eawag-squid/SQUID/img/plugged.JPG

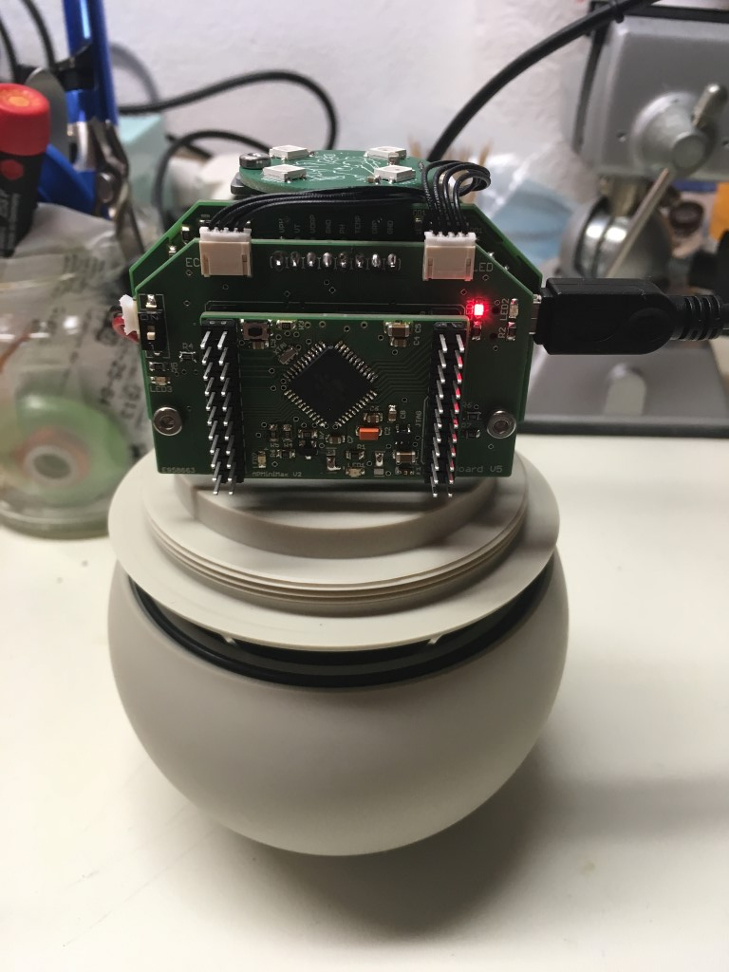
img/plugged.JPG
