eawag-squid/SQUID/img/Window_6.JPG

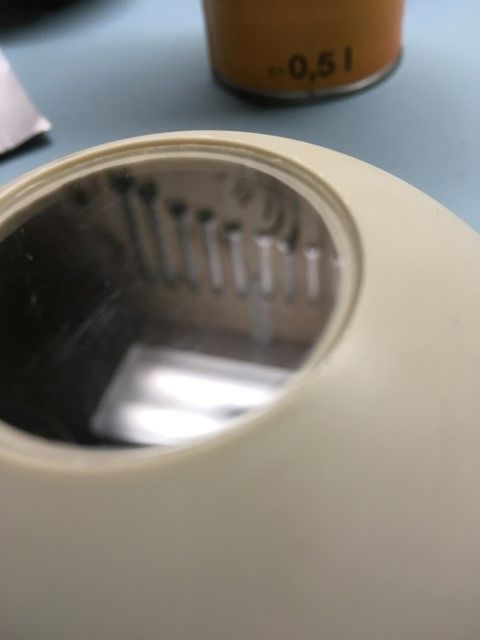
img/Window_6.JPG
