eawag-squid/SQUID/README.md

# SQUID
Repository holding Eawag's SQUID user documentation and latest firmware versions.
Check back frequently!

Check the [wiki](https://github.com/eawag-squid/SQUID/wiki) for User Documentation.
