eawag-squid/SQUID/hardware/APMiniMax_V2/APMiniMax_Pinout.docx

FTDI

| | AP MiniMax Pinout

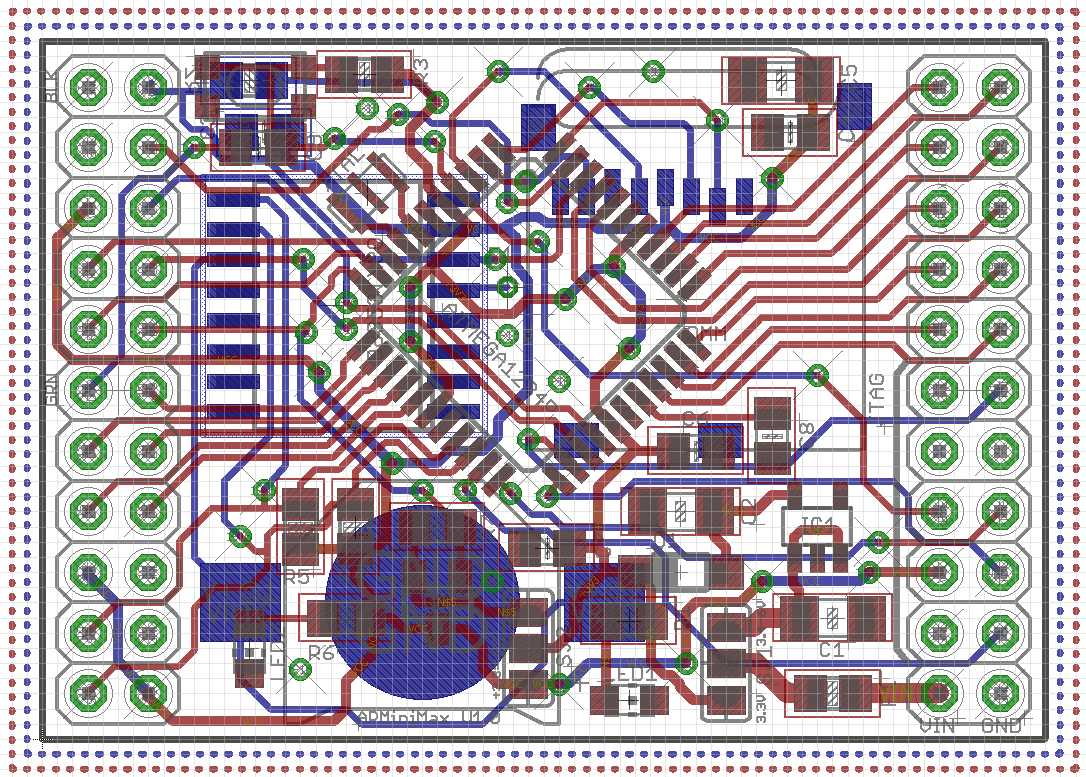
[picture p3: figure]

GND | INT2 | | A0 | A1
GND | B3 | | A2 | A3
VCC | C7 | | UART_RX | UART_TX
RXI | C6 | | A4 | A5
RXO | D2 | | A6 | A7
DTR | D3 | | GND | TDI
D4 | D5 | | N.C. | N.C.
D6 | D7 | | RESET | TMS
VCC | GND | | VCC | TDO JTAG
SCL | GND | | GND | TCK
SDA | VCC | | VIN | GND
