eawag-squid/SQUID/hardware/APMiniMax_V2/pinout.xlsx

GND | INT2 | A0 | A1
GND | B3 | A2 | A3
+3V3 | C7 | UART_RX | UART_TX
RXI | C6 | A4 | A5
RXO | D2 | A6 | A7
DTR | D3 | GND | TDI
D4 | D5 | NC | NC
D6 | D7 | RESET | TMS
VCC | GND | +3V3 | TDO
SCL | GND | GND | TCK
SDA | VCC | VIN | GND
