eawag-squid/SQUID/hardware/ECBoard_V3/ECBoard_v3_PLACE_BOT.pdf

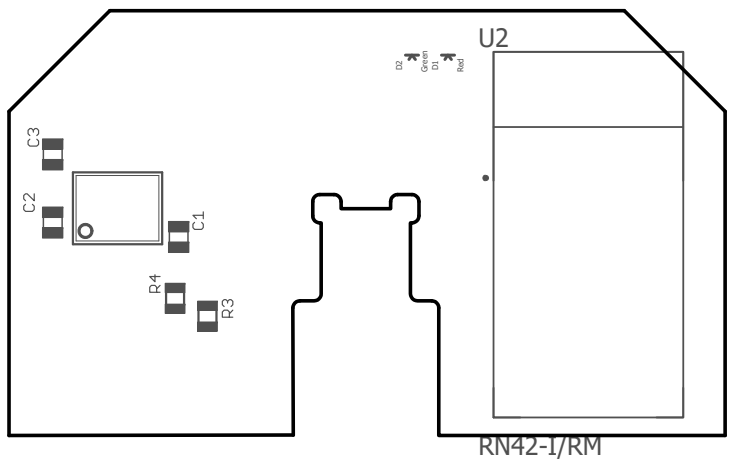
[picture p4: figure]
U2 Green; Red
