eawag-squid/SQUID/hardware/ECBoard_V3/ECBoard_v3_PLACE_TOP.pdf

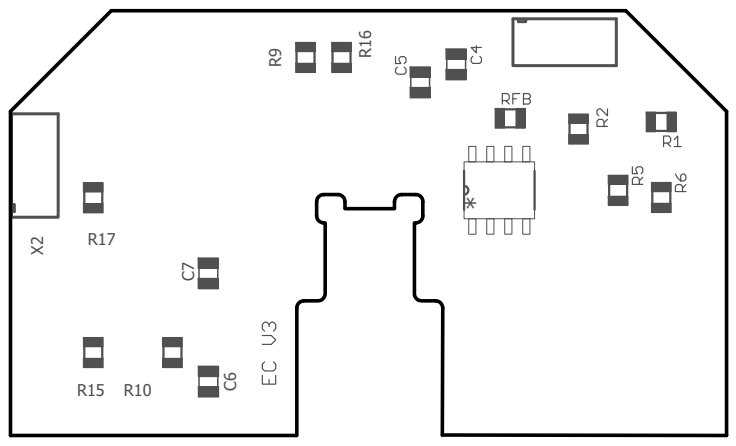
[picture p5: figure]
