eawag-squid/SQUID/img/Corners pointing in.JPG

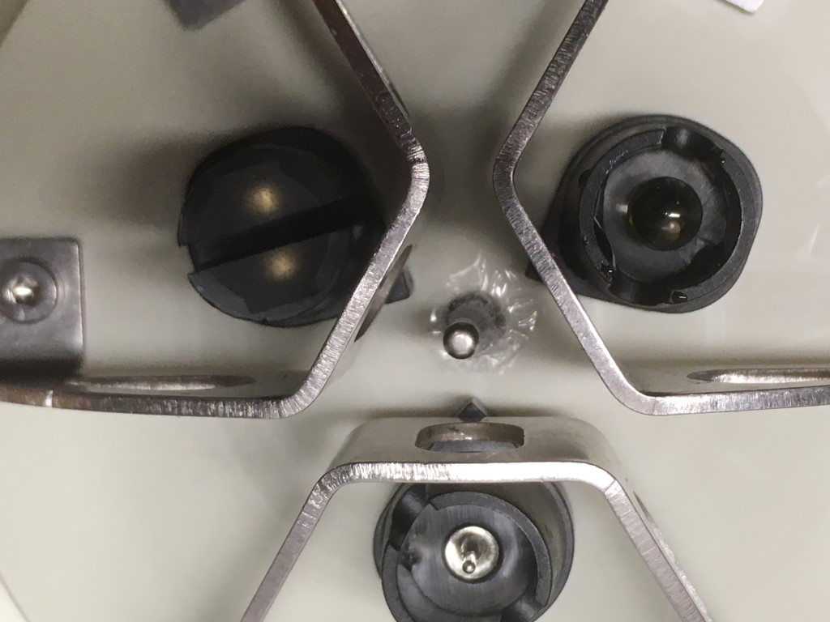
img/Corners pointing in.JPG
