eawag-squid/SQUID/img/downloadfiles.JPG

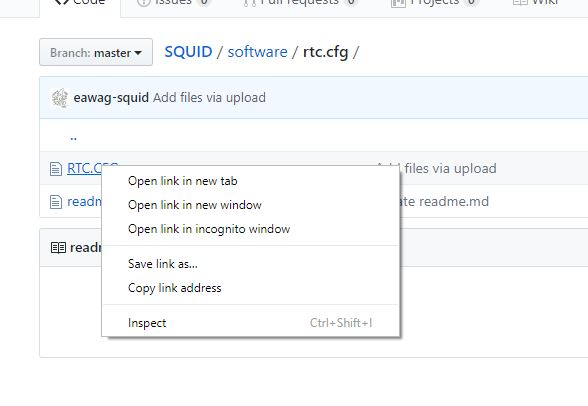
img/downloadfiles.JPG
