eawag-squid/SQUID/img/EC_calValues.PNG

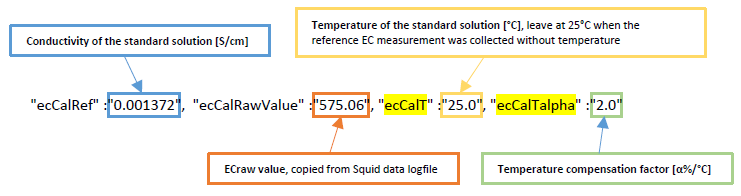
img/EC_calValues.PNG
