eawag-squid/SQUID/img/EC_freqOptimization.PNG

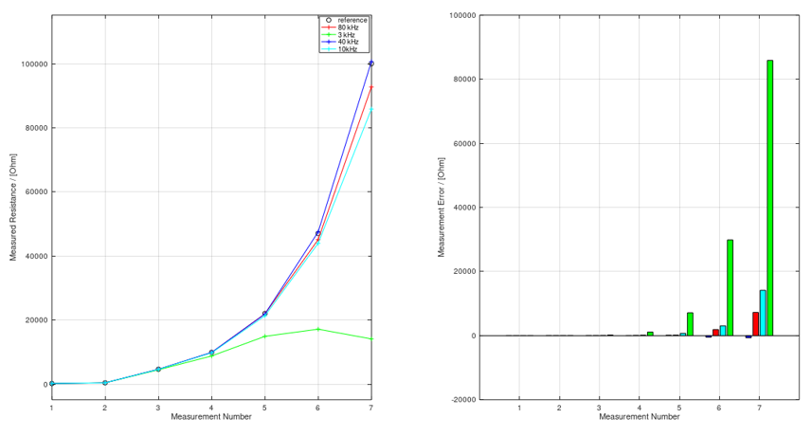
img/EC_freqOptimization.PNG
