eawag-squid/SQUID/img/fullycharged.JPG

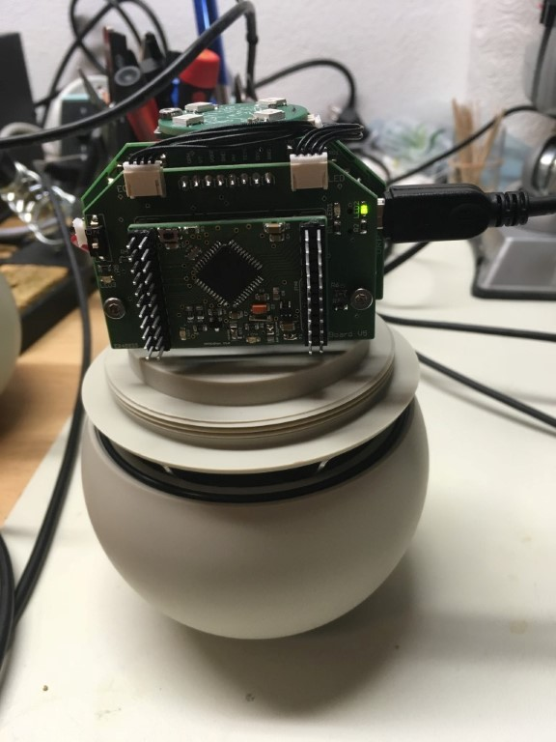
img/fullycharged.JPG
