eawag-squid/SQUID/img/OnSwitch.JPG

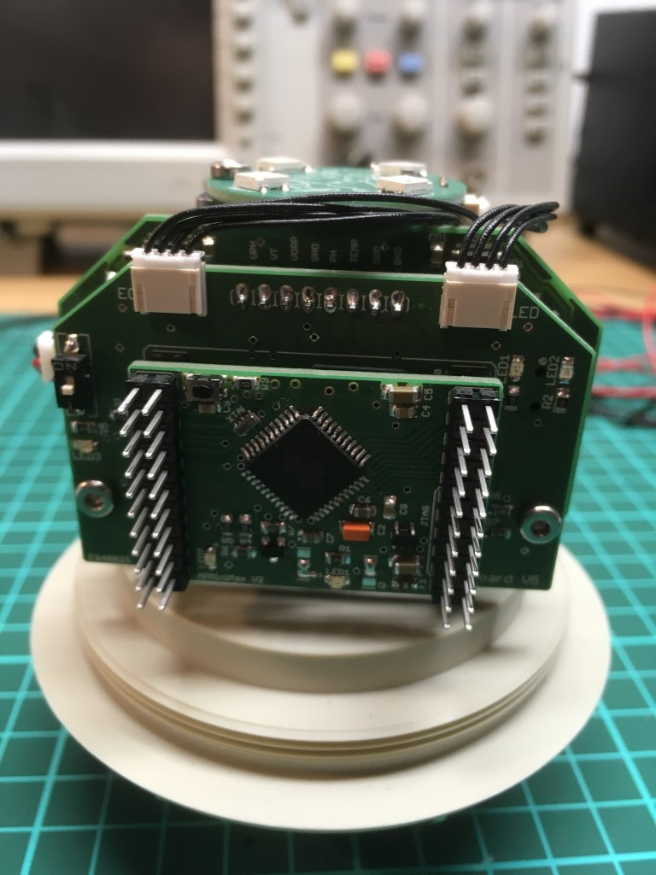
img/OnSwitch.JPG
