eawag-squid/SQUID/img/ORingBeforeInsert.JPG

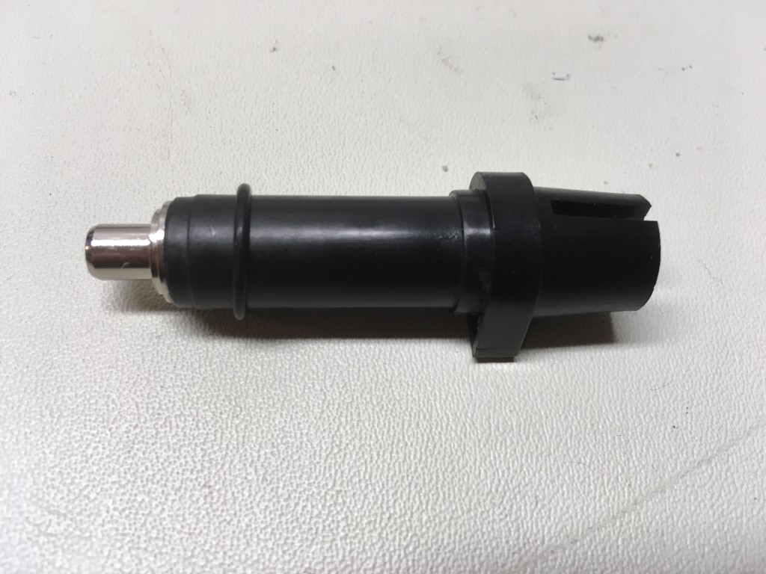
img/ORingBeforeInsert.JPG
