eawag-squid/SQUID/img/ORP_AfterRefresh.JPG

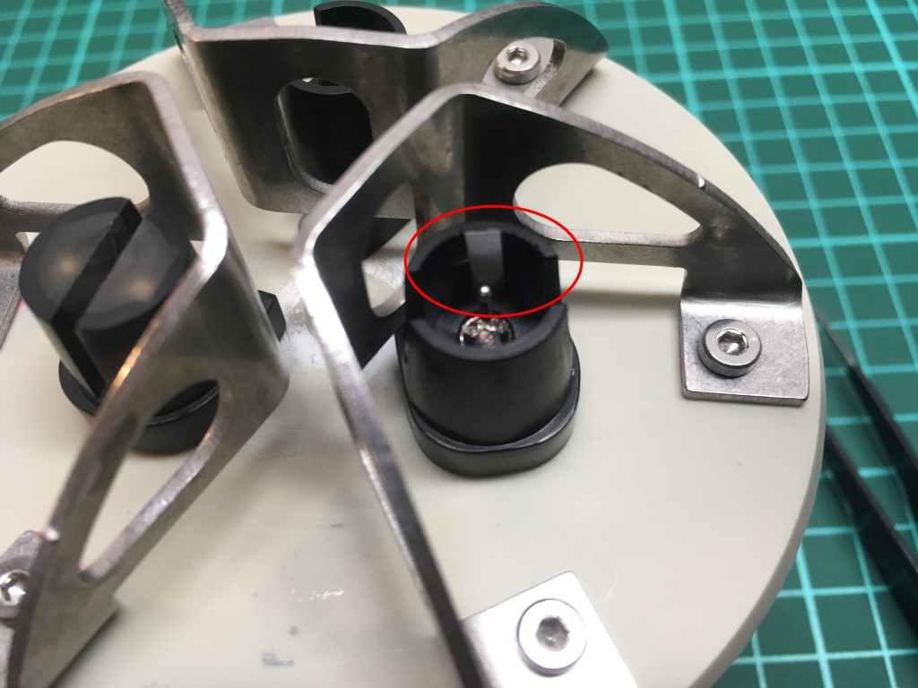
img/ORP_AfterRefresh.JPG
