eawag-squid/SQUID/img/ORP_BeforeRefresh.JPG

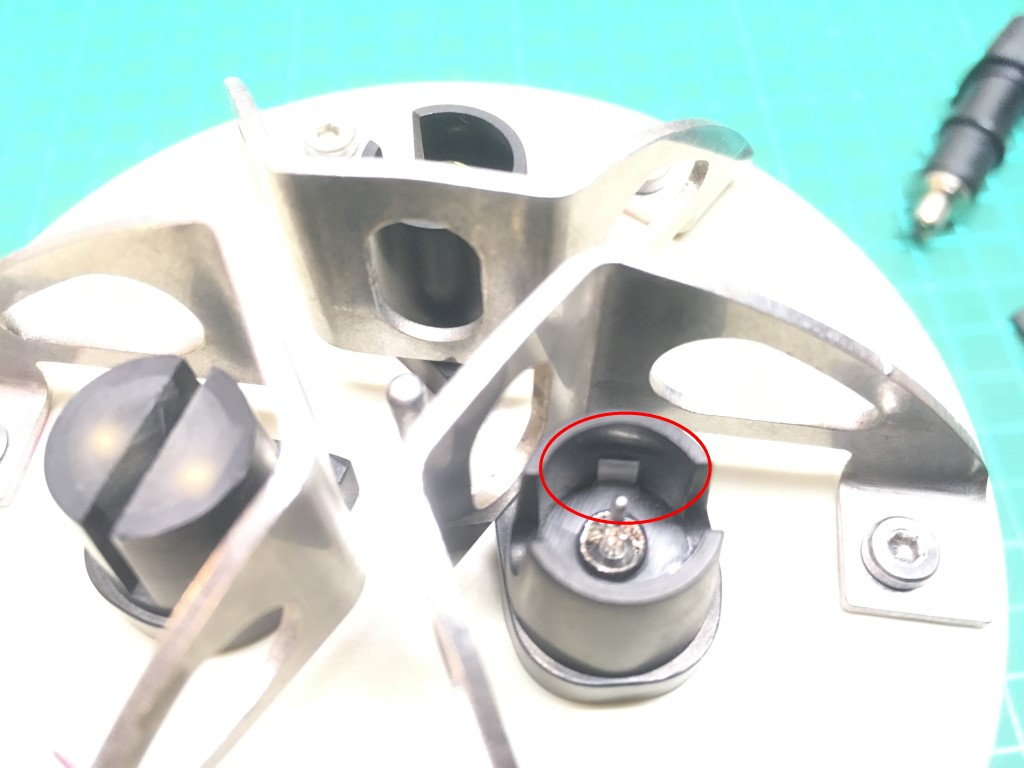
img/ORP_BeforeRefresh.JPG
