eawag-squid/SQUID/img/pH_17-022.png

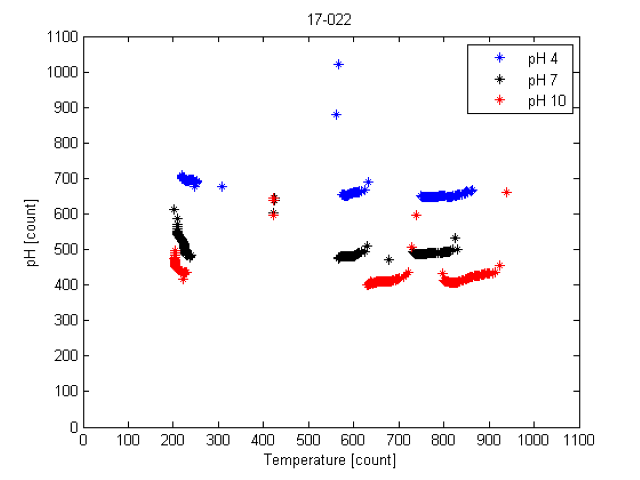
img/pH_17-022.png
