eawag-squid/SQUID/img/pH_17-022_modelled.png

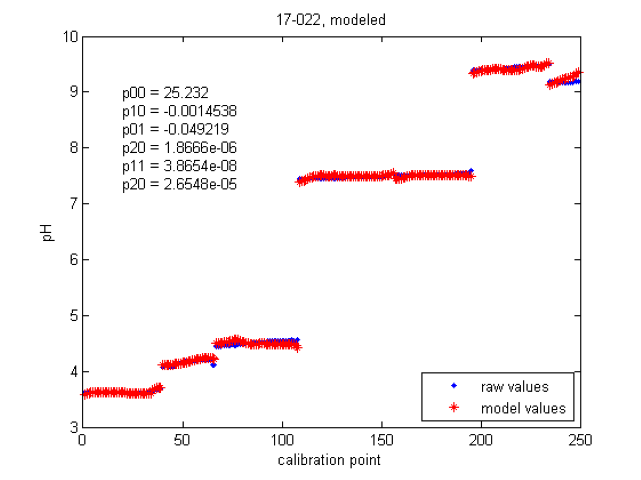
img/pH_17-022_modelled.png
