eawag-squid/SQUID/img/pH_17-022_modelvsHACH.png

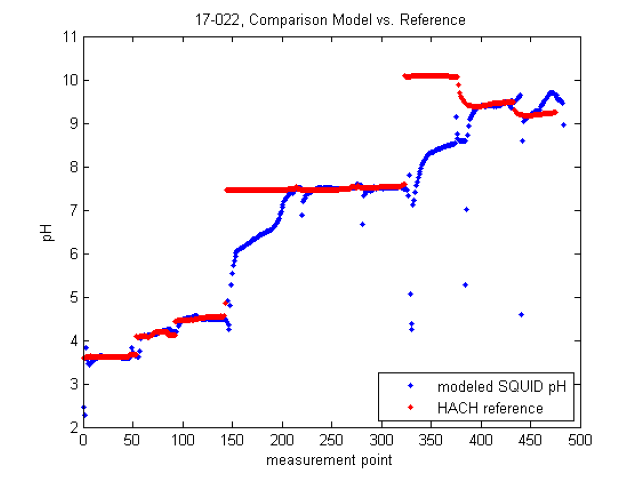
img/pH_17-022_modelvsHACH.png
