eawag-squid/SQUID/img/putty_configuration.png

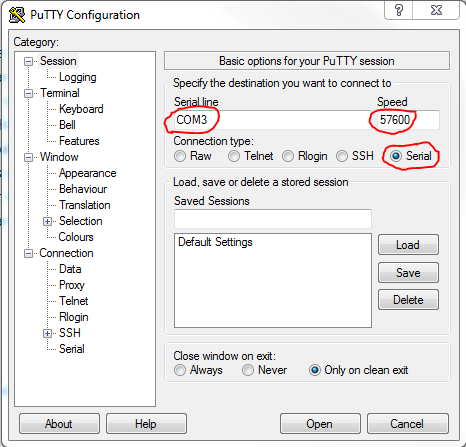
img/putty_configuration.png
