eawag-squid/SQUID/img/reconfigure_bluetooth_module.jpg

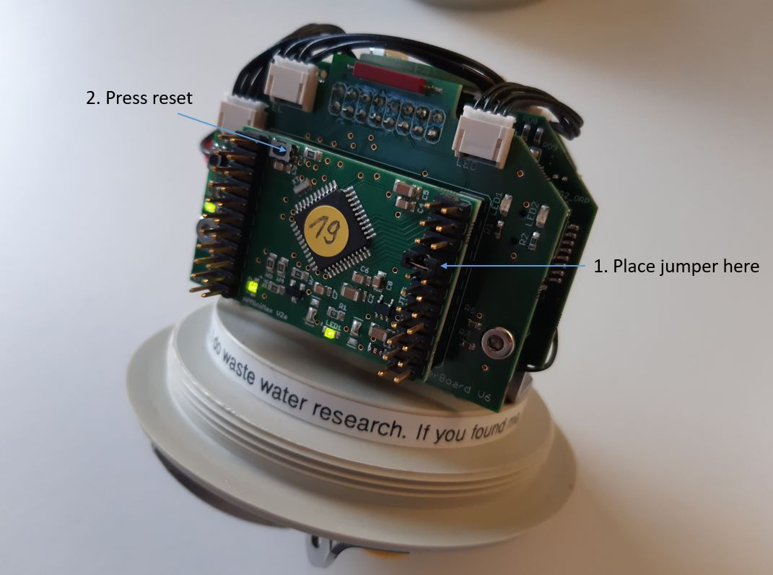
img/reconfigure_bluetooth_module.jpg
