eawag-squid/SQUID/img/squid_with_carrier_board_v6.jpg

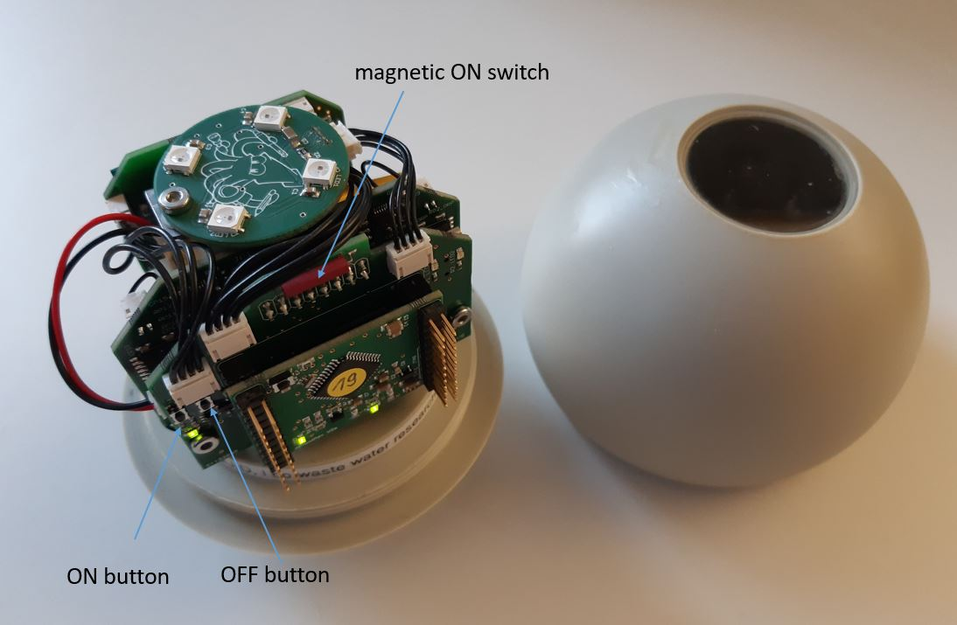
img/squid_with_carrier_board_v6.jpg
