eawag-squid/SQUID/img/squid_with_ecboard_v3.jpg

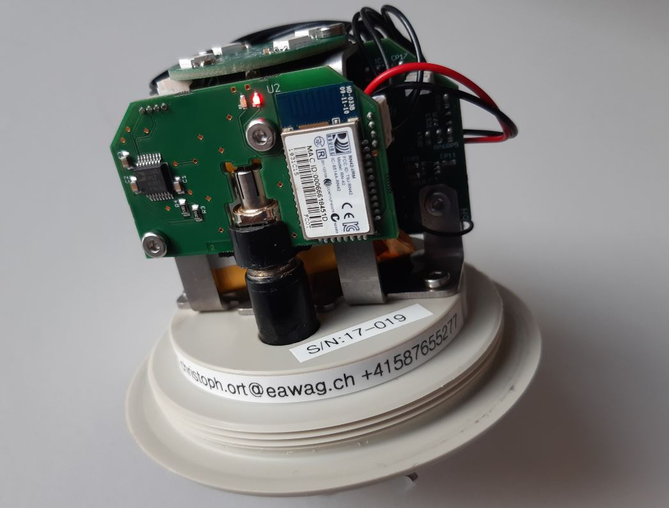
img/squid_with_ecboard_v3.jpg
