eawag-squid/SQUID/img/squid_with_ecboard_v3_connected.jpg

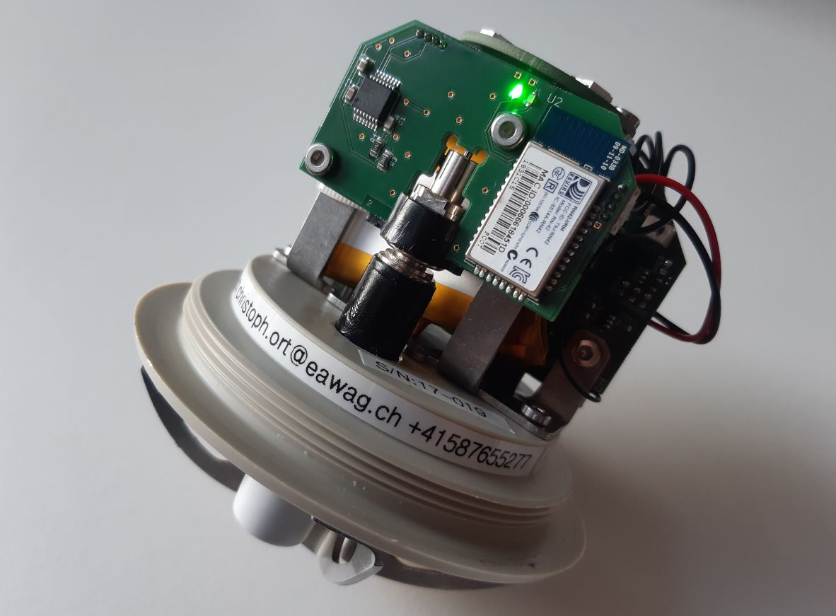
img/squid_with_ecboard_v3_connected.jpg
