eawag-squid/SQUID/img/Squid_ZGUI.png

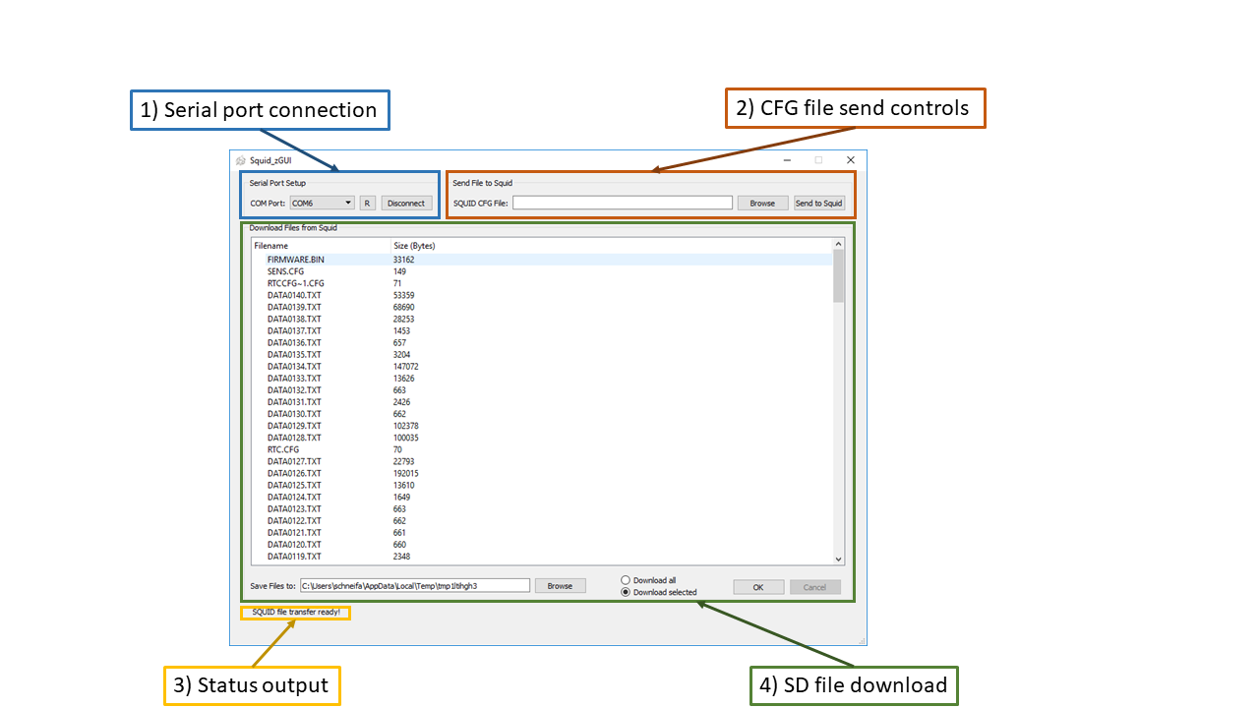
img/Squid_ZGUI.png
