eawag-squid/SQUID/img/SQUIDKit.JPG

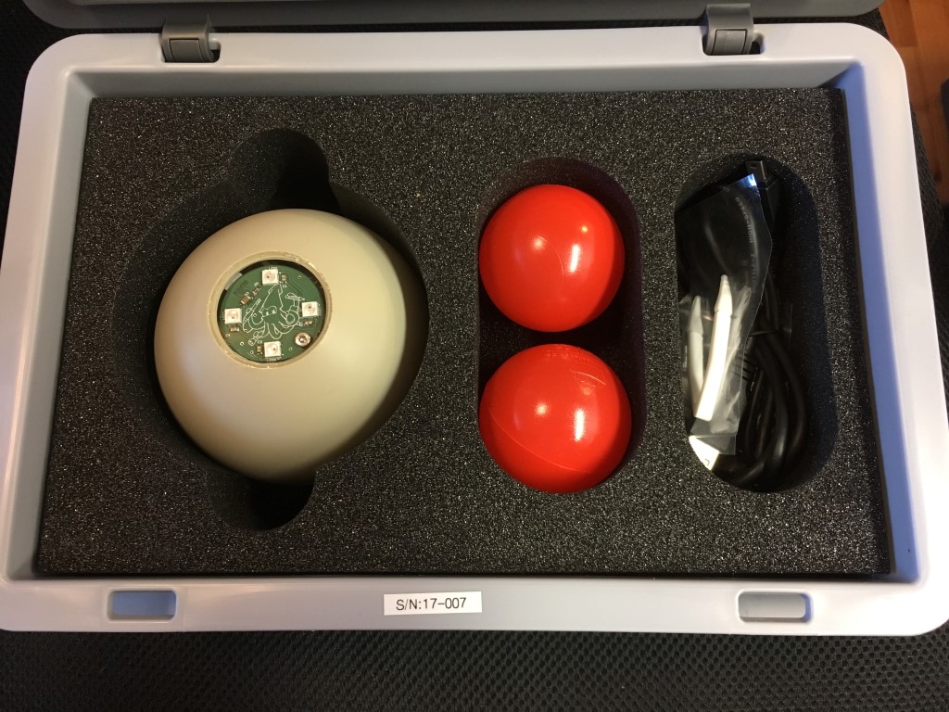
img/SQUIDKit.JPG
