eawag-squid/SQUID/img/SQUIDOpen.JPG

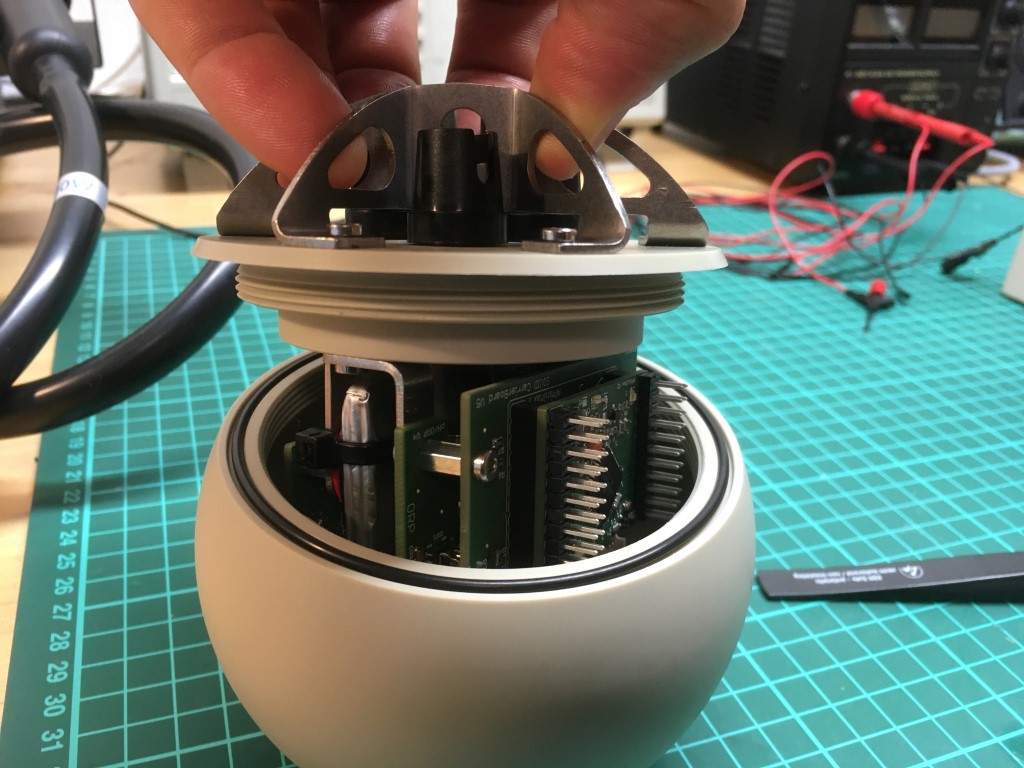
img/SQUIDOpen.JPG
