eawag-squid/SQUID/img/UsingInsetTool.JPG

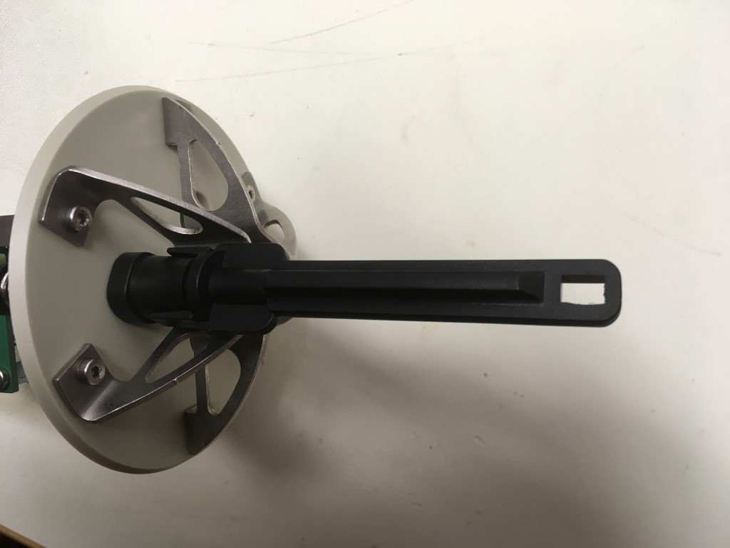
img/UsingInsetTool.JPG
