eawag-squid/SQUID/img/Window_1.JPG

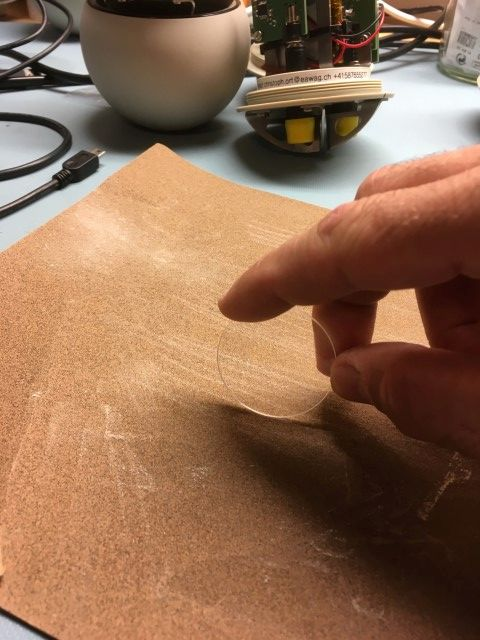
img/Window_1.JPG
