eawag-squid/SQUID/img/Window_2.JPG

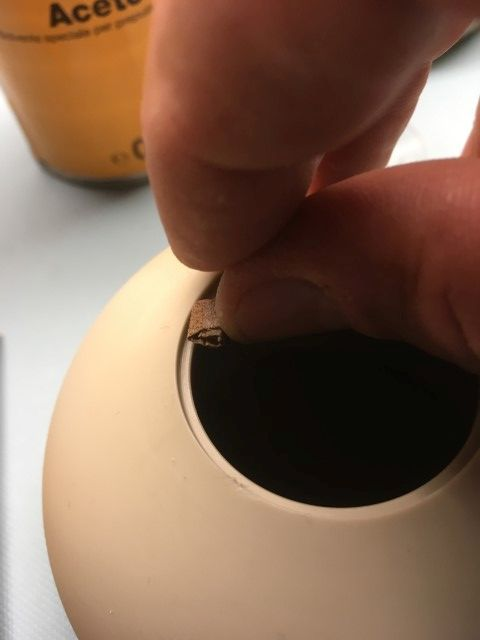
img/Window_2.JPG
