eawag-squid/SQUID/img/Window_3.JPG

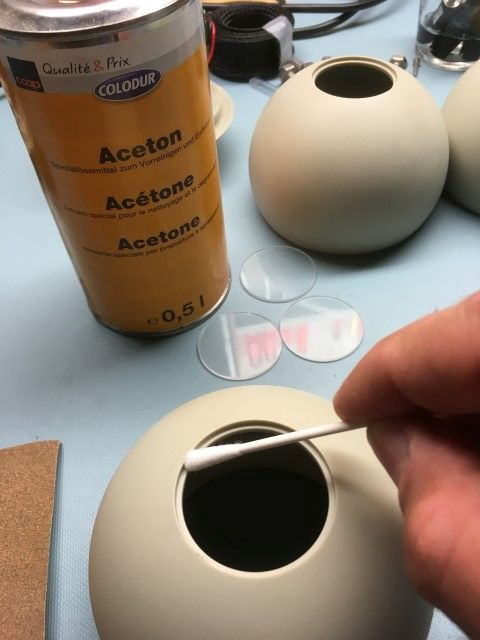
img/Window_3.JPG
