eawag-squid/SQUID/img/Window_4.JPG

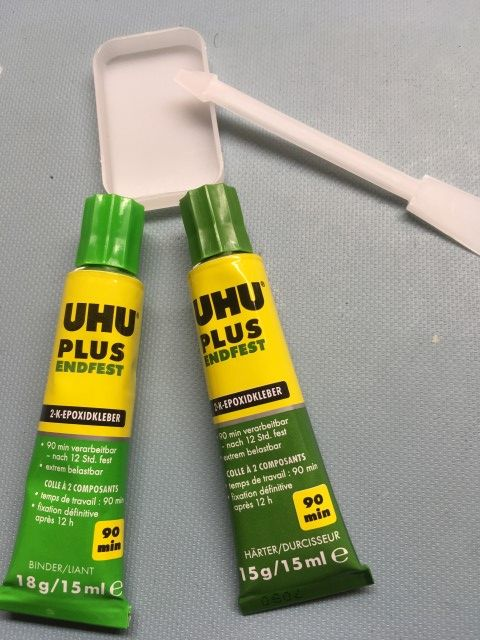
img/Window_4.JPG
