eawag-squid/SQUID/img/Window_5.JPG

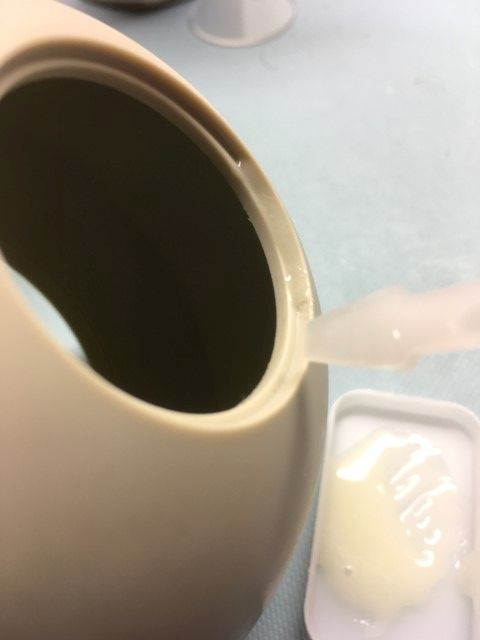
img/Window_5.JPG
