eawag-squid/SQUID/img/EC_referenceMeasurement.PNG

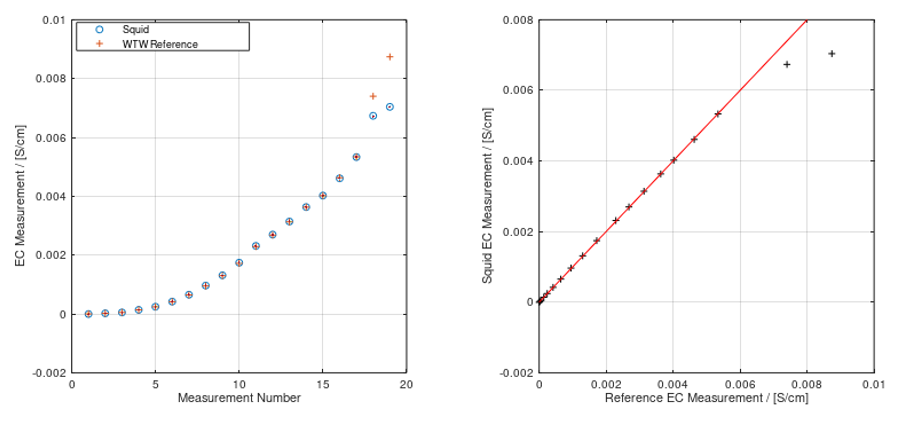
img/EC_referenceMeasurement.PNG
