eawag-squid/SQUID/(threads)

Thread 1 (2022-03-04):

Interprétation des données graphique de la Sewerball

BILIMBA, 2022-03-04:
Bonjour,
Avez-vous un document explicatif des différents paramètres graphique (PH, conductivité, redox, température)?
Comment interpréter les données lorsqu'il s'agit d'un réseau EU ou EP?
cdt.
