eawag-squid/SQUID/hardware/ECBoard_V3/ECBoard_v3.pdf

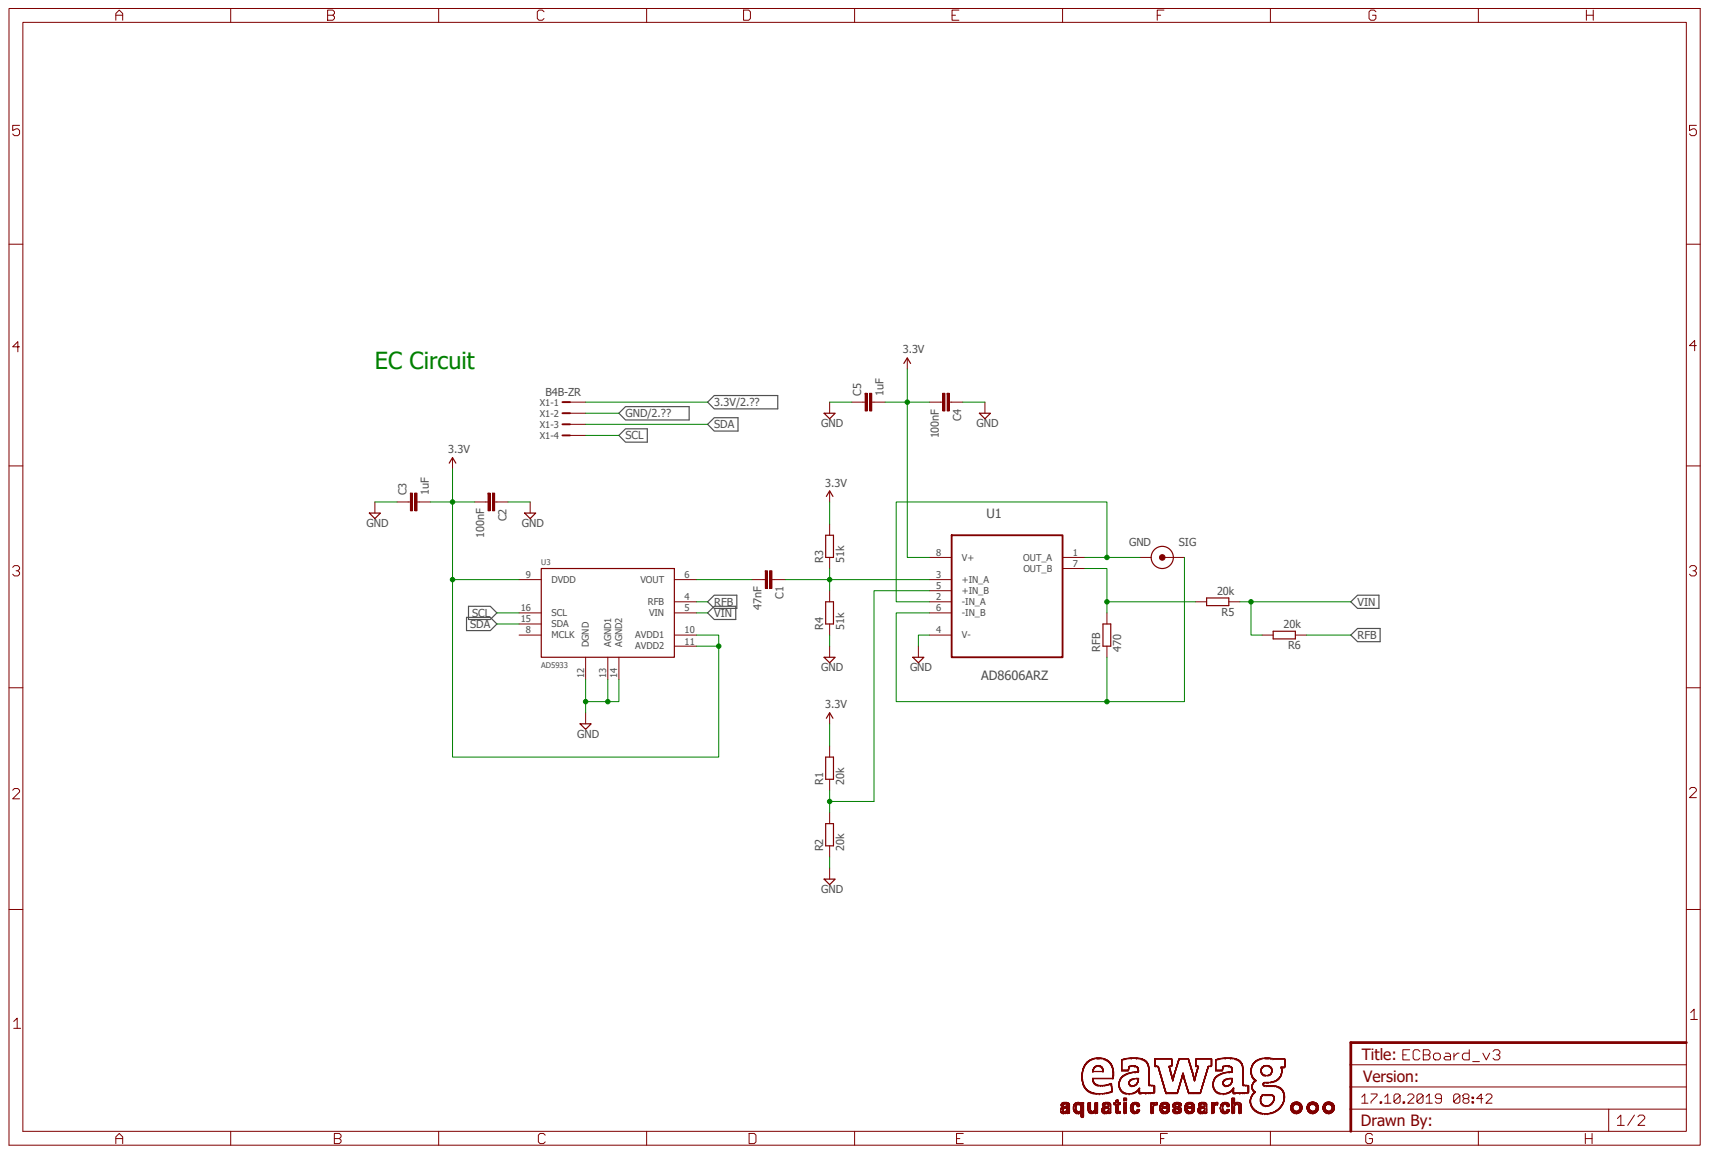
[picture p36: page 1]

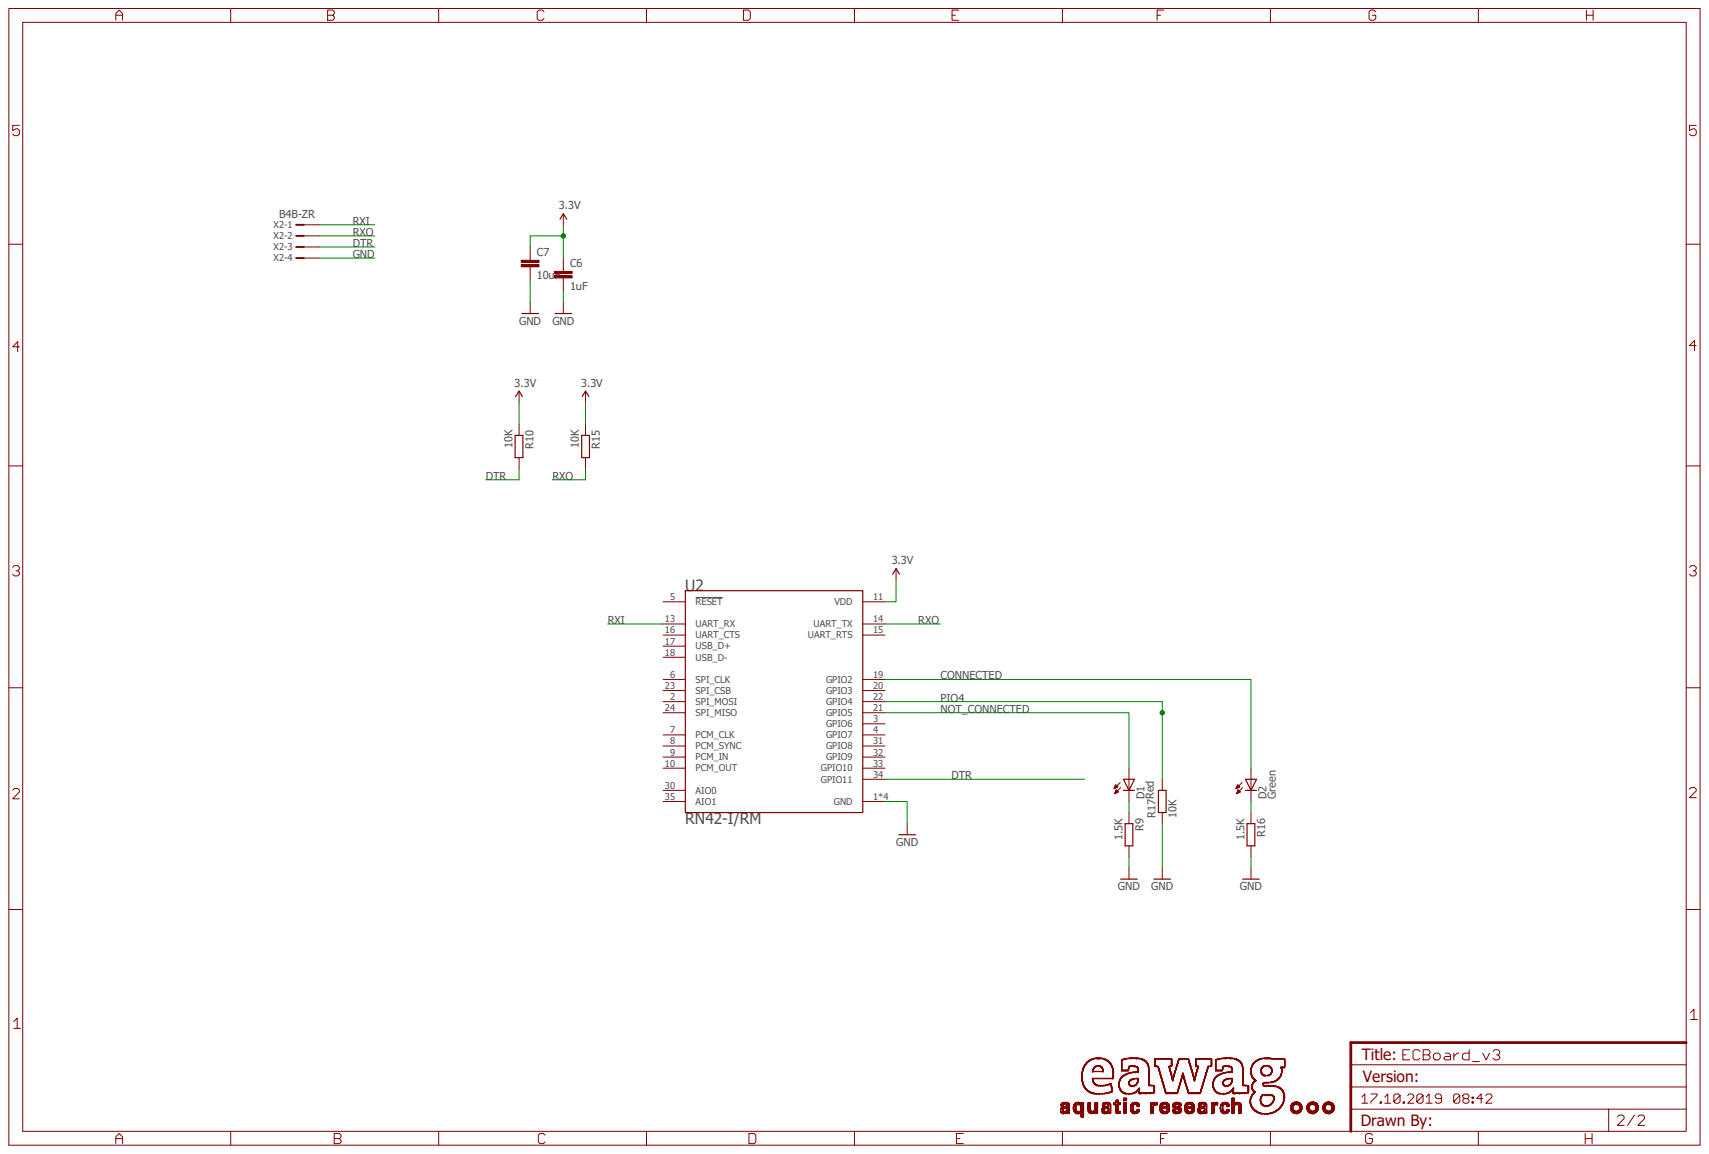
[picture p37: page 2]
