eawag-squid/SQUID/hardware/CarrierBoard_V7/CarrierBoard_V7.brd

## EAGLE design hardware/CarrierBoard_V7/CarrierBoard_V7.brd (2019-11-29)

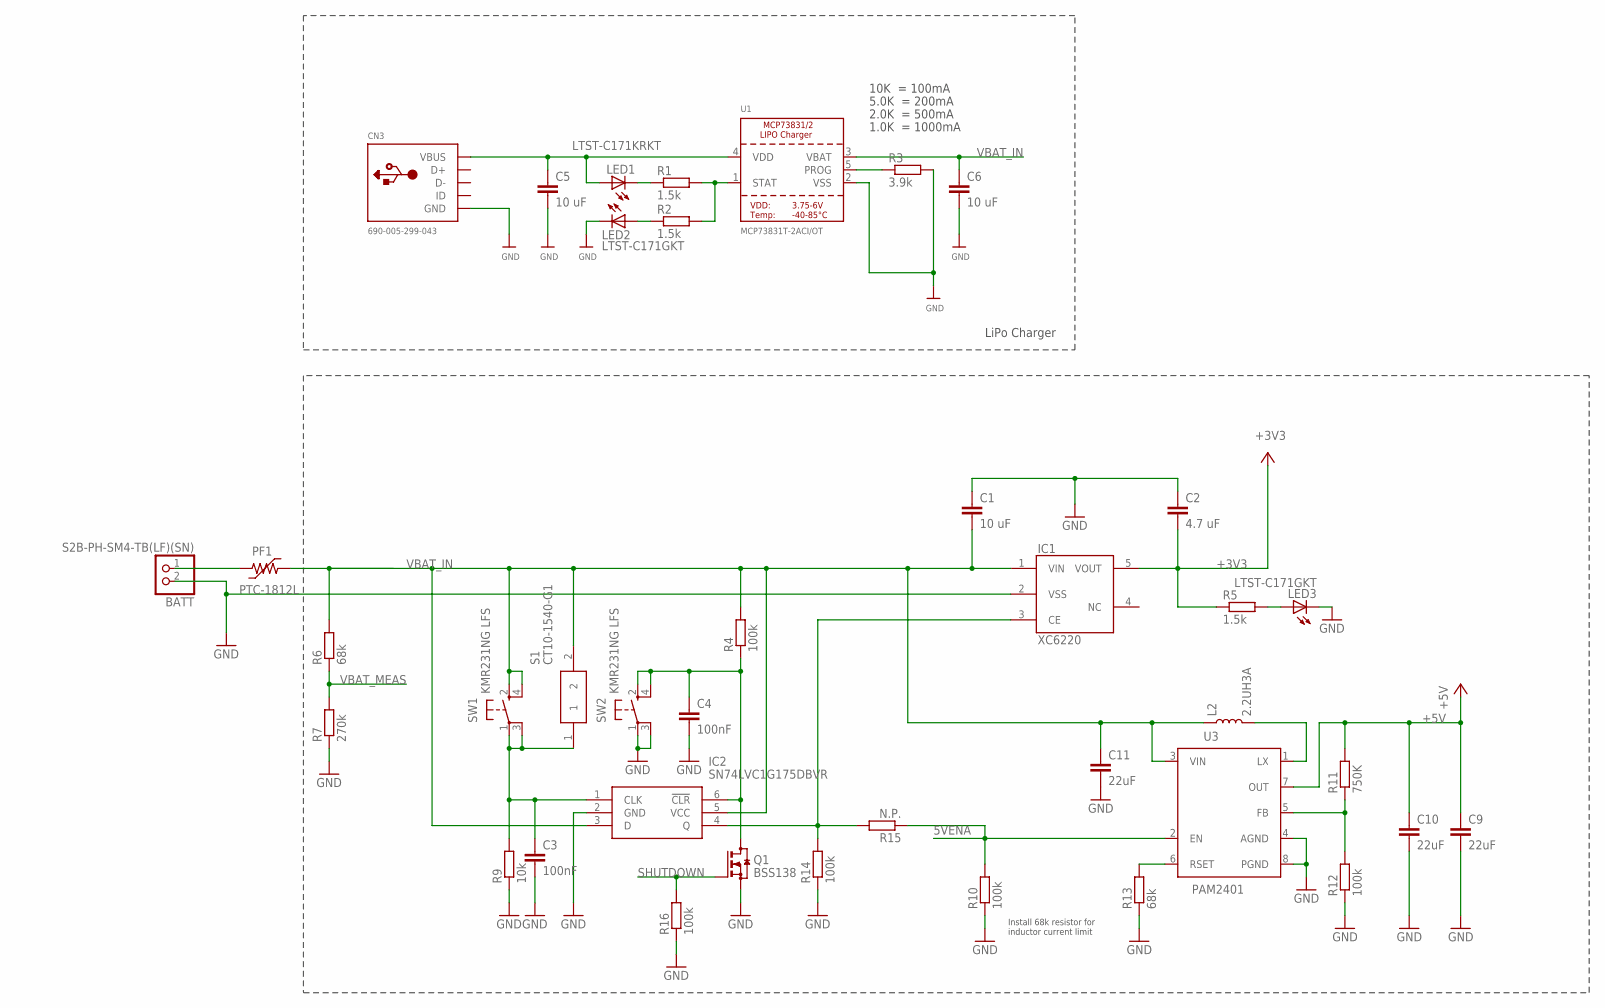
[picture p38: schematic CarrierBoard_V7.sch, sheet 1]

Parts:
BATT: S2B-PH-SM4-TB(LF)(SN); JST-PH-2-SMT-RA
C1, C5, C6: 10 uF; C1206
C2: 4.7 uF; C1206
C3, C4: 100nF; C0603
C9, C10, C11: 22uF; C0805
CN3: 690-005-299-043; USB-MINIB
IC1: XC6220SOT-25; SOT25
IC2: SN74LVC1G175DBVR; SOT95P280X145-6N
L2: 2.2UH3A; INDUCTOR_4X4MM
LED1: LTST-C171KRKT; CHIPLED_0805
LED2, LED3: LTST-C171GKT; CHIPLED_0805
PF1: PTC-1812L; 1812L
Q1: BSS138; SOT23
R1, R2, R5: 1.5k; R0603
R3: 3.9k; R0603
R4, R10, R12, R14, R16: 100k; R0603
R6, R13: 68k; R0603
R7: 270k; R0603
R9: 10k; R0603
R11: 750K; R0603
R15: N.P.; R0603
S1: CT10-1540-G1; CT101540G1
SW1, SW2: KMR231NG LFS; KMR2
U1: MCP73831T-2ACI/OT; SOT23-5
U3: PAM2401; MSOP8

Connections:
5VENA: R10.2, R15.1, U3.2 (EN); also elsewhere on the board
+3V3: C2.2, IC1.5 (VOUT), R5.1; also elsewhere on the board
+5V: C9.1, C10.1, R11.2, U3.7 (OUT); also elsewhere on the board
CLR: C4.1, IC2.6 (!CLR), Q1.3 (D), R4.1, SW2.2 (S), SW2.4 (S1)
GND: BATT.2 (1), C1.1, C2.1, C3.2, C4.2, C5.2, C6.2, C9.2, C10.2, C11.2, CN3.GND, IC1.2 (VSS), IC2.2 (GND), LED2.C, LED3.C, Q1.2 (S), R3.2, R7.1, R9.1, R10.1, R12.1, R13.1, R14.1, R16.1, SW2.1, SW2.3 (P1), U1.2 (VSS), U3.4 (AGND), U3.8 (PGND); also elsewhere on the board
unnamed: LED1.C, R1.1
unnamed: R11.1, R12.2, U3.5 (FB)
unnamed: R1.2, R2.2, U1.1 (STAT)
unnamed: R3.1, U1.5 (PROG)
unnamed: LED3.A, R5.2
unnamed: BATT.1 (2), PF1.1
unnamed: L2.P$2 (2), U3.1 (LX)
unnamed: R13.2, U3.6 (RSET)
unnamed: LED2.A, R2.1
ON: C3.1, IC2.1 (CLK), R9.2, S1.1, SW1.1, SW1.3 (P1)
PWR_ENABLE: IC1.3 (CE), IC2.4 (Q), R14.2, R15.2
SHUTDOWN: Q1.1 (G), R16.2; also elsewhere on the board
VBAT_IN: C1.2, C6.1, C11.1, IC1.1 (VIN), IC2.3 (D), IC2.5 (VCC), L2.P$1 (1), PF1.2, R4.2, R6.2, S1.2, SW1.2 (S), SW1.4 (S1), U1.3 (VBAT), U3.3 (VIN)
VBAT_MEAS: R6.1, R7.2; also elsewhere on the board
VDD1: C5.1, CN3.VBUS, LED1.A, U1.4 (VDD)

Notes on the sheet:
10K = 100mA
5.0K = 200mA
2.0K = 500mA
1.0K = 1000mA
LiPo Charger
Install 68k resistor for inductor current limit

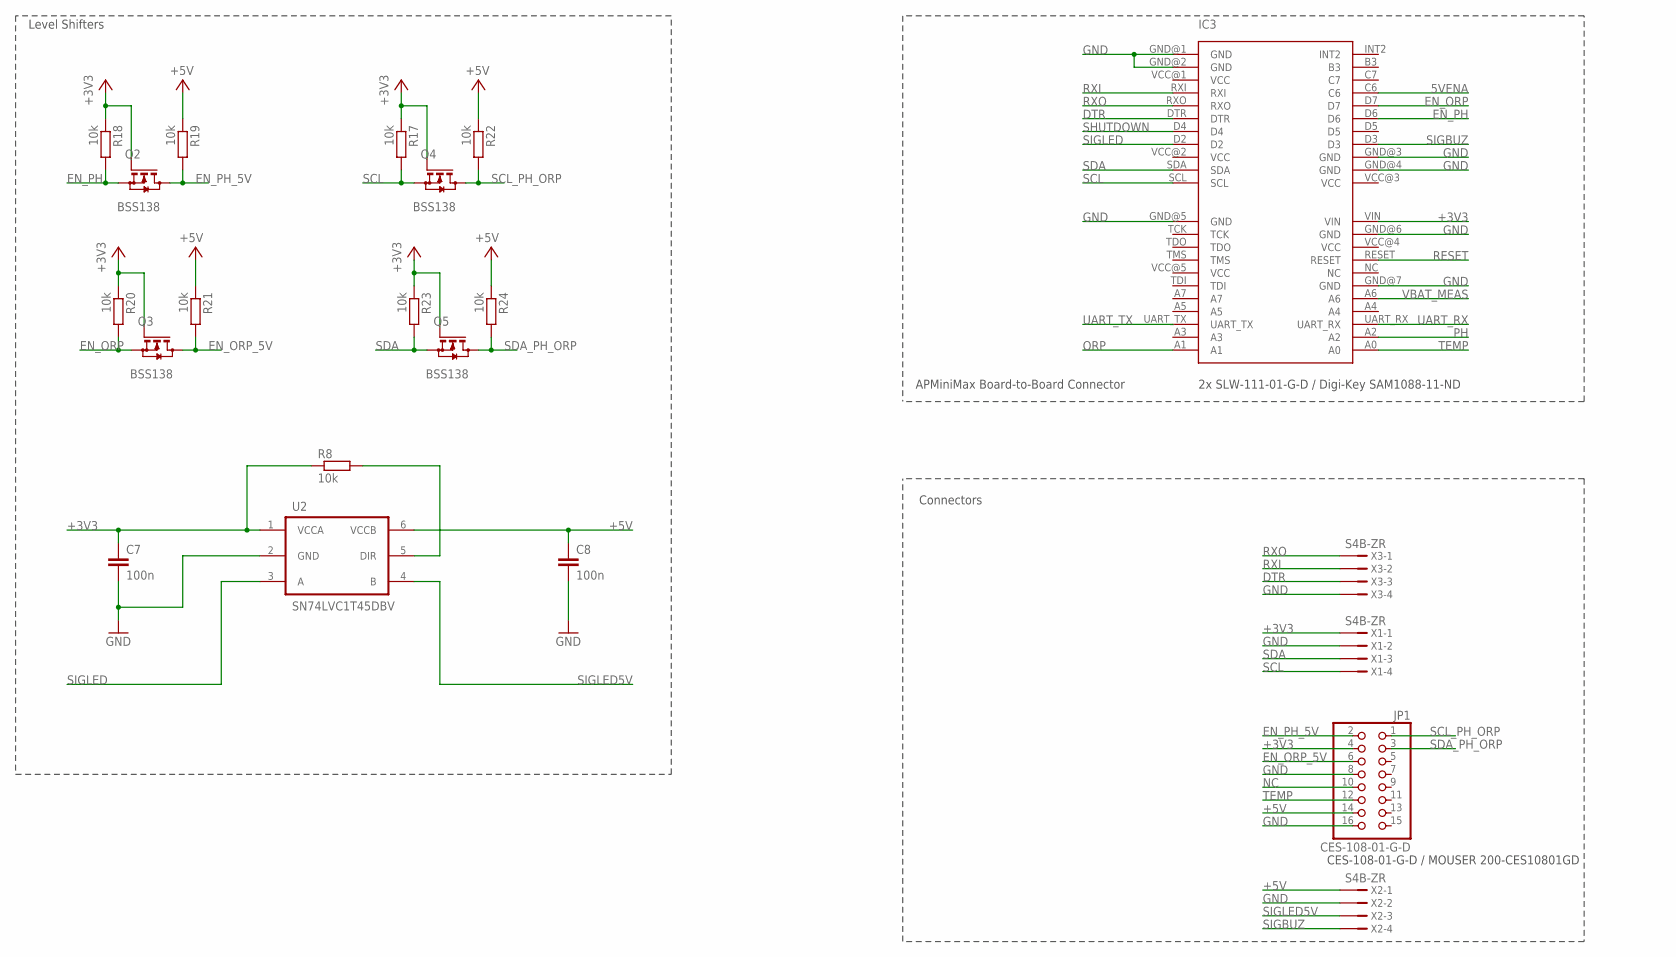
[picture p39: schematic CarrierBoard_V7.sch, sheet 2]

Parts:
C7, C8: 100n; C0805
IC3: SLW-111-01-G-D; APE
JP1: CES-108-01-G-D; 2X08
Q2, Q3, Q4, Q5: BSS138; SOT23
R8, R17, R18, R19, R20, R21, R22, R23, R24: 10k; R0603
U2: SN74LVC1T45DBV; SOT23-6
X1, X2, X3: S4B-ZR

Connections:
5VENA: IC3.C6; also elsewhere on the board
+3V3: C7.1, IC3.VIN, JP1.4, Q2.1 (G), Q3.1 (G), Q4.1 (G), Q5.1 (G), R8.1, R17.1, R18.1, R20.1, R23.1, U2.1 (VCCA), X1.1; also elsewhere on the board
+5V: C8.1, JP1.14, R19.1, R21.1, R22.1, R24.1, U2.6 (VCCB), X2.1; also elsewhere on the board
DTR: IC3.DTR, X3.3
EN_ORP: IC3.D7, Q3.2 (S), R20.2
EN_ORP_5V: JP1.6, Q3.3 (D), R21.2
EN_PH: IC3.D6, Q2.2 (S), R18.2
EN_PH_5V: JP1.2, Q2.3 (D), R19.2
GND: C7.2, C8.2, IC3.GND@1 (GND), IC3.GND@2 (GND), IC3.GND@3 (GND), IC3.GND@4 (GND), IC3.GND@5 (GND), IC3.GND@6 (GND), IC3.GND@7 (GND), JP1.8, JP1.16, U2.2 (GND), X1.2, X2.2, X3.4; also elsewhere on the board
unnamed: R8.2, U2.5 (DIR)
NC: JP1.10
ORP: IC3.A1
PH: IC3.A2
RESET: IC3.RESET
RXI: IC3.RXI, X3.2
RXO: IC3.RXO, X3.1
SCL: IC3.SCL, Q4.2 (S), R17.2, X1.4
SCL_PH_ORP: JP1.1, Q4.3 (D), R22.2
SDA: IC3.SDA, Q5.2 (S), R23.2, X1.3
SDA_PH_ORP: JP1.3, Q5.3 (D), R24.2
SHUTDOWN: IC3.D4; also elsewhere on the board
SIGBUZ: IC3.D3, X2.4
SIGLED: IC3.D2, U2.3 (A)
SIGLED5V: U2.4 (B), X2.3
TEMP: IC3.A0, JP1.12
UART_RX: IC3.UART_RX
UART_TX: IC3.UART_TX
VBAT_MEAS: IC3.A6; also elsewhere on the board

Notes on the sheet:
Level Shifters
APMiniMax Board-to-Board Connector
Connectors
2x SLW-111-01-G-D / Digi-Key SAM1088-11-ND
CES-108-01-G-D / MOUSER 200-CES10801GD

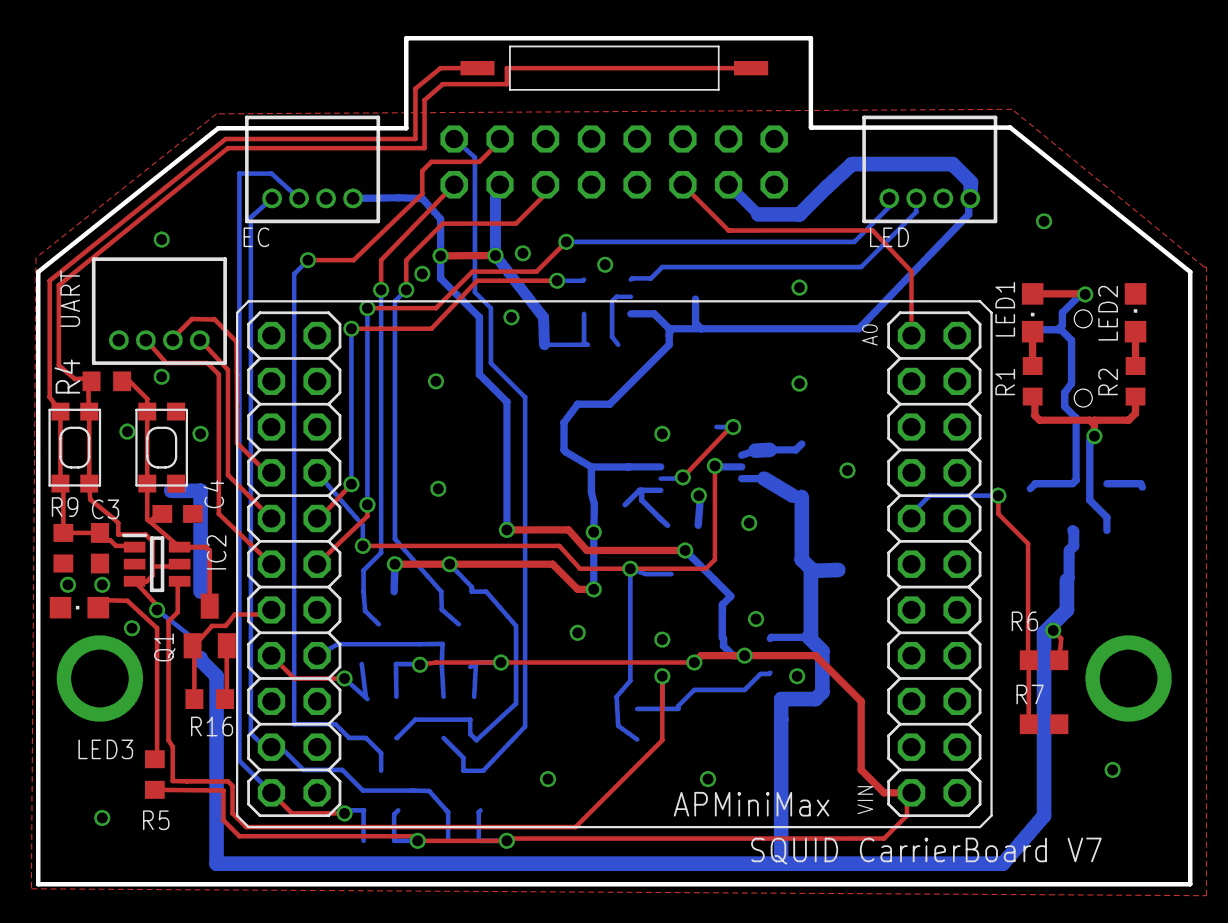
[picture p40: board CarrierBoard_V7.brd from above]

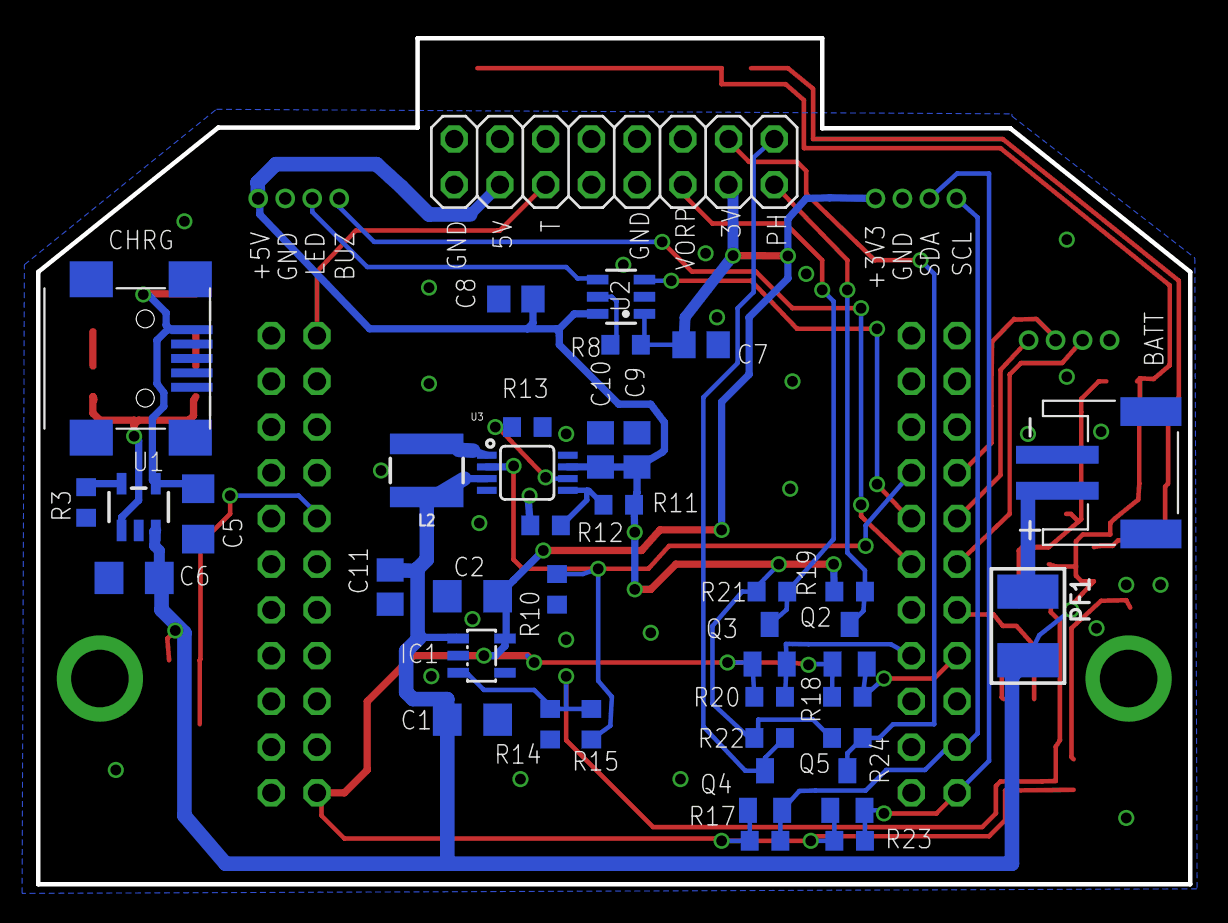
[picture p41: board CarrierBoard_V7.brd from below]

Board: 2 copper layers, 64.0 x 47.0 mm, 60 parts (38 on the bottom side), 36 nets.
