eawag-squid/SQUID/hardware/pHORPBoard_V10/pHORPBoard_V10.brd

## EAGLE design hardware/pHORPBoard_V10/pHORPBoard_V10.brd (2019-11-29)

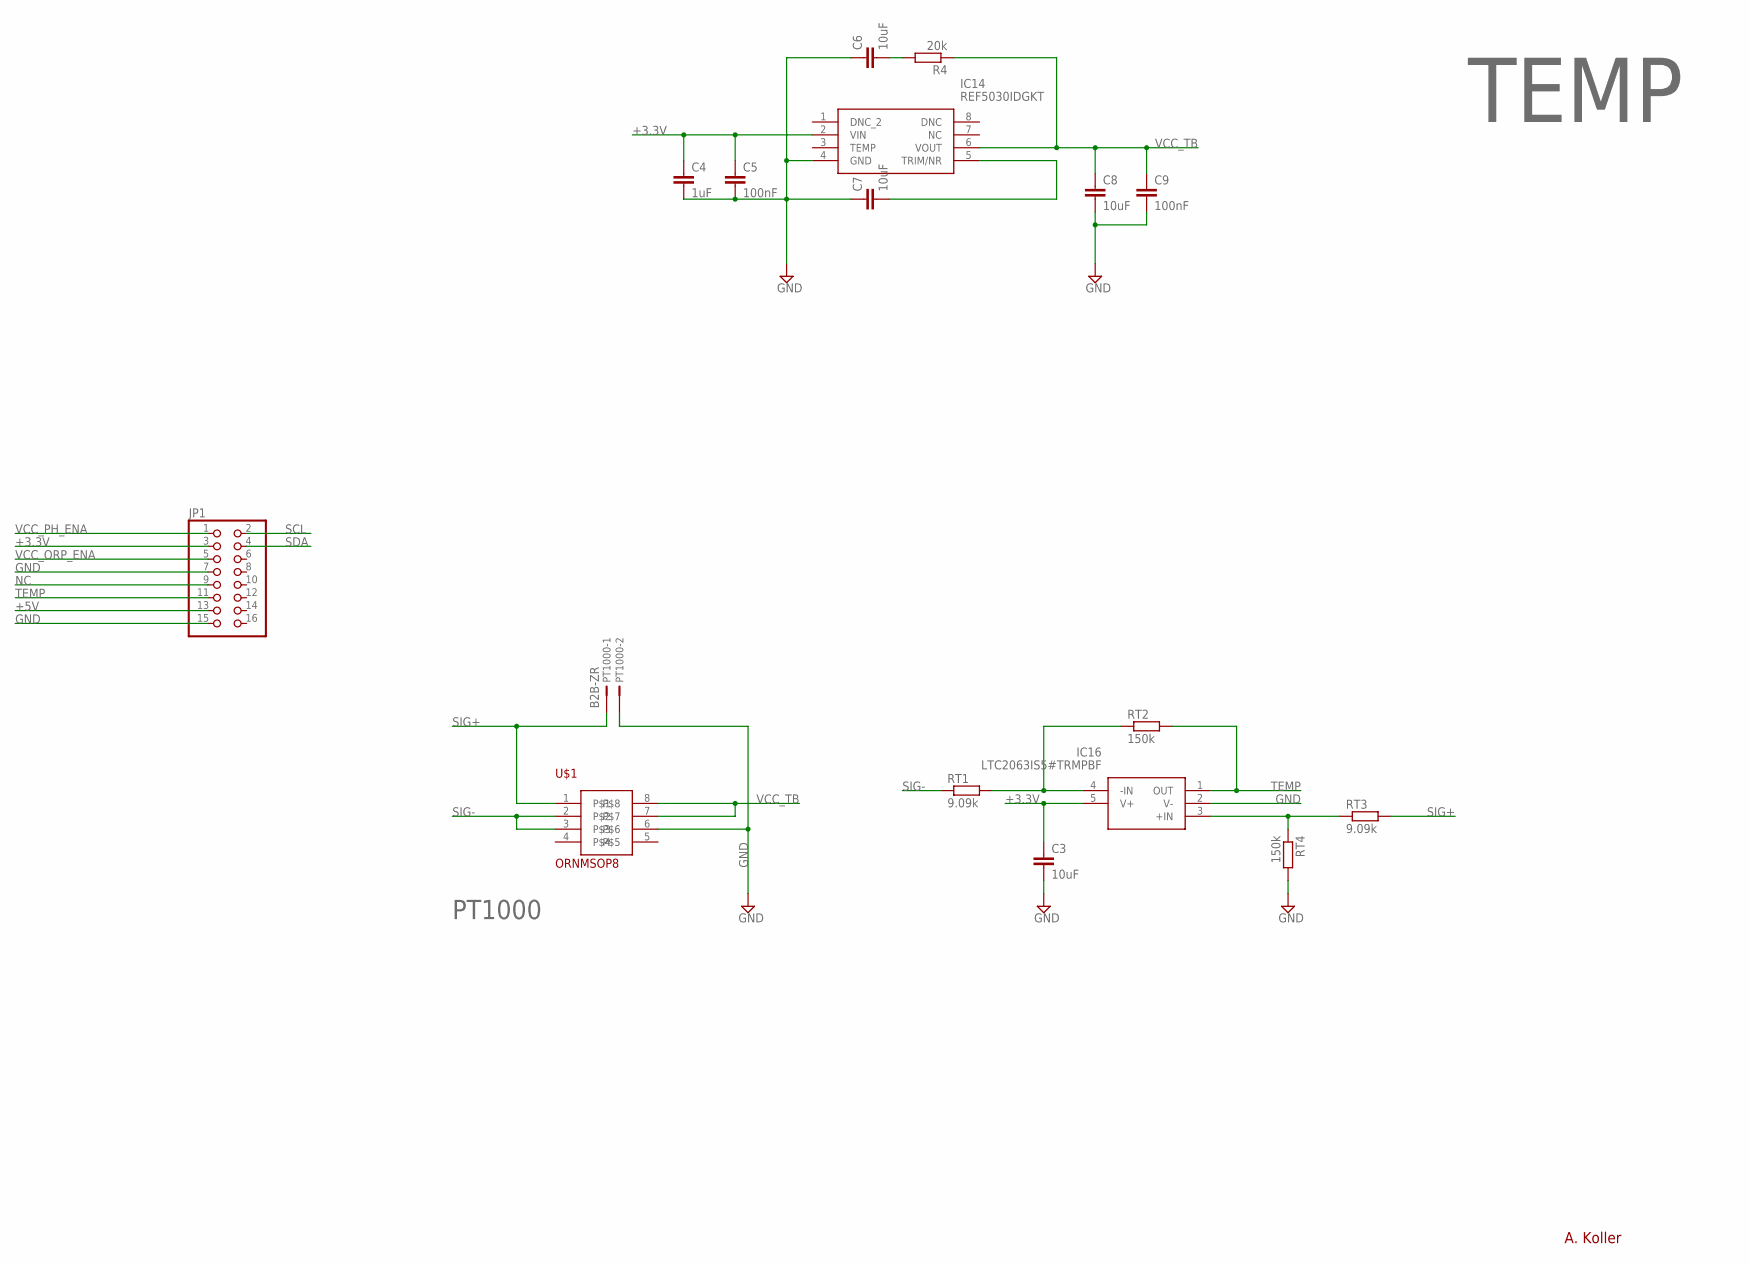
[picture p42: schematic pHORPBoard_V10.sch, sheet 1]

Parts:
C3, C6, C7, C8: 10uF; C0603
C4: 1uF; C0603
C5, C9: 100nF; C0603
IC14: REF5030IDGKT; SOP65P490X110-8N
IC16: LTC2063IS5#TRMPBF; SOT95P280X100-5N
JP1: PINHD-2X8; 2X08
PT1000: B2B-ZR
R4: 20k; R0603
RT1, RT3: 9.09k; R0603
RT2, RT4: 150k; R0603
U$1: ORNMSOP8; MSOP8

Connections:
+3.3V: C3.1, C4.1, C5.1, IC14.2 (VIN), IC16.5 (V+), JP1.3
+5V: JP1.13; also elsewhere on the board
GND: C3.2, C4.2, C5.2, C6.1, C7.1, C8.2, C9.2, IC14.4 (GND), IC16.2 (V-), JP1.7, JP1.15, PT1000.2, RT4.2, U$1.6; also elsewhere on the board
unnamed: IC16.4 (-IN), RT1.2, RT2.1
unnamed: IC16.3 (+IN), RT3.1, RT4.1
unnamed: C6.2, R4.2
unnamed: C7.2, IC14.5 (TRIM/NR)
NC: JP1.9
SCL: JP1.2; also elsewhere on the board
SDA: JP1.4; also elsewhere on the board
SIG+: PT1000.1, RT3.2, U$1.1
SIG-: RT1.1, U$1.2, U$1.3
TEMP: IC16.1 (OUT), JP1.11, RT2.2
VCC_ORP_ENA: JP1.5; also elsewhere on the board
VCC_PH_ENA: JP1.1; also elsewhere on the board
VCC_TB: C8.1, C9.1, IC14.6 (VOUT), R4.1, U$1.7, U$1.8

Notes on the sheet:
PT1000
A. Koller
TEMP

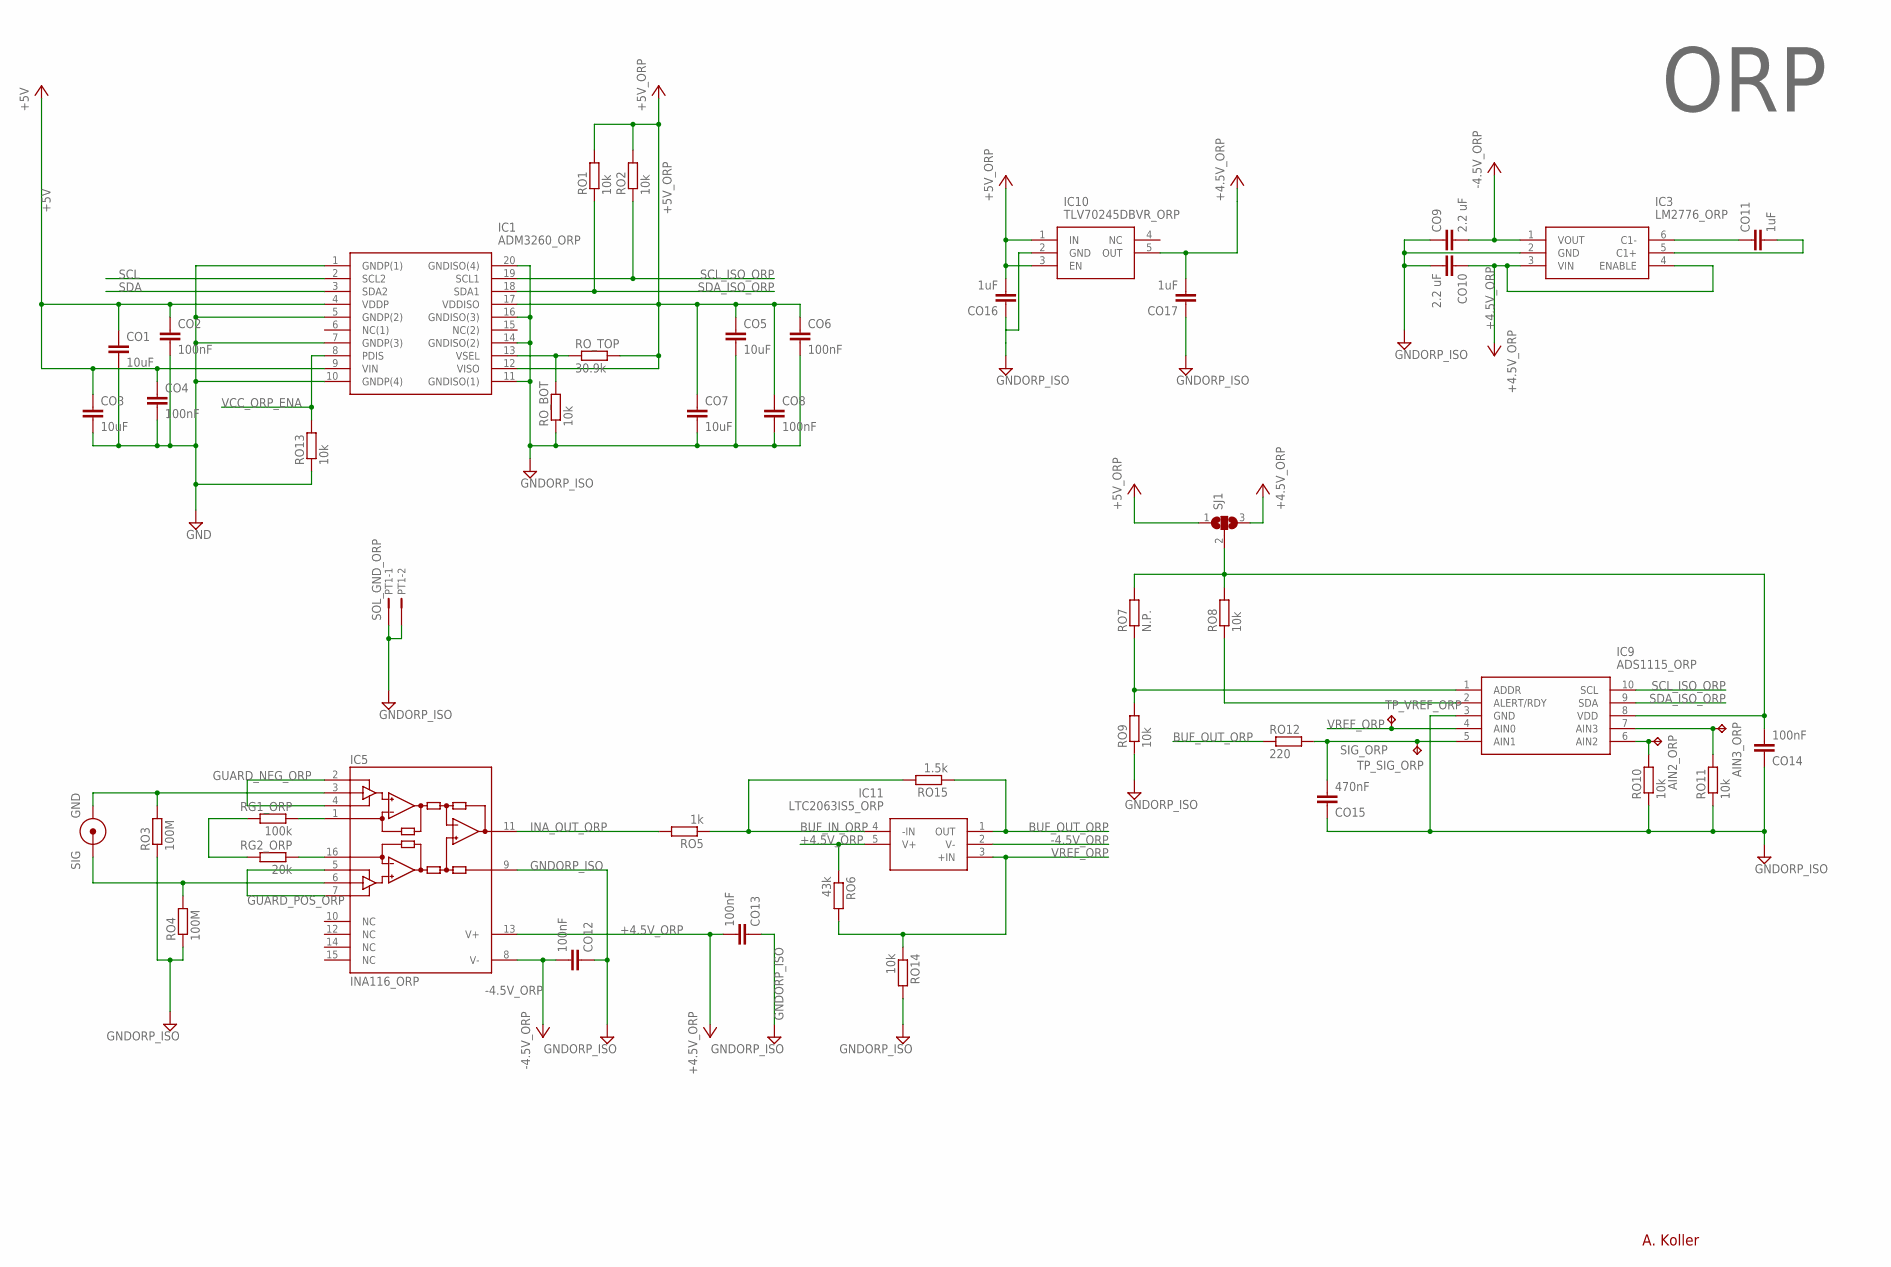
[picture p43: schematic pHORPBoard_V10.sch, sheet 2]

Parts:
AIN2_ORP, AIN3_ORP: TPB1,27; B1,27
CO1, CO3, CO5, CO7: 10uF; C0603
CO2, CO4, CO6, CO8, CO12, CO13, CO14: 100nF; C0603
CO9, CO10: 2.2 uF; C0603
CO11, CO16, CO17: 1uF; C0603
CO15: 470nF; C0603
IC1: ADM3260_ORP; SOP65P780X200-20N
IC3: LM2776_ORP; SOT95P280X145-6N
IC5: INA116_ORP; SO16-1
IC9: ADS1115_ORP; SOP50P490X110-10N
IC10: TLV70245DBVR_ORP; SOT95P280X145-5N
IC11: LTC2063IS5_ORP; SOT95P280X100-5N
ORP: CON_HANNACON_HANNA_2; CON_HANNA_2
PT1: SOL_GND_ORP; B2B-ZR
RG1_ORP: 100k; R0603
RG2_ORP: 20k; R0603
RO1, RO2, RO8, RO9, RO10, RO11, RO13, RO14: 10k; R0603
RO3, RO4: 100M; R0603
RO5: 1k; R0603
RO6: 43k; R0603
RO7: N.P.; R0603
RO12: 220; R0603
RO15: 1.5k; R0603
RO_BOT: 10k; R0603
RO_TOP: 30.9k; R0603
SJ1: SJ2W; SJ_2
TP_SIG_ORP: TPB1,27; B1,27
TP_VREF_ORP: TPB1,27; B1,27

Connections:
+4.5V_ORP: CO10.1, CO13.2, CO17.2, IC3.3 (VIN), IC3.4 (ENABLE), IC5.13 (V+), IC10.5 (OUT), IC11.5 (V+), RO6.1, SJ1.3
+5V: CO1.1, CO2.1, CO3.1, CO4.1, IC1.4 (VDDP), IC1.9 (VIN); also elsewhere on the board
+5V_ORP: CO5.1, CO6.1, CO7.1, CO8.1, CO16.2, IC1.12 (VISO), IC1.17 (VDDISO), IC10.1 (IN), IC10.3 (EN), RO1.2, RO2.2, RO_TOP.2, SJ1.1
-4.5V_ORP: CO9.2, CO12.2, IC3.1 (VOUT), IC5.8 (V-), IC11.2 (V-)
BUF_IN_ORP: IC11.4 (-IN), RO5.1, RO15.2
BUF_OUT_ORP: IC11.1 (OUT), RO12.1, RO15.1
GND: CO1.2, CO2.2, CO3.2, CO4.2, IC1.1 (GNDP(1)), IC1.5 (GNDP(2)), IC1.7 (GNDP(3)), IC1.10 (GNDP(4)), RO13.1; also elsewhere on the board
GNDORP_ISO: CO5.2, CO6.2, CO7.2, CO8.2, CO9.1, CO10.2, CO12.1, CO13.1, CO14.1, CO15.1, CO16.1, CO17.1, IC1.11 (GNDISO(1)), IC1.14 (GNDISO(2)), IC1.16 (GNDISO(3)), IC1.20 (GNDISO(4)), IC3.2 (GND), IC5.9 (REF), IC9.3 (GND), IC10.2 (GND), PT1.1, PT1.2, RO3.1, RO4.1, RO9.1, RO10.1, RO11.1, RO14.2, RO_BOT.1
GUARD_NEG_ORP: IC5.2 (GUARD-), IC5.4 (GUARD-)
GUARD_POS_ORP: IC5.5 (GUARD+), IC5.7 (GUARD+)
INA_OUT_ORP: IC5.11 (OUT), RO5.2
unnamed: IC5.6 (+IN), ORP.CON_SIG, RO4.2
unnamed: CO11.1, IC3.6 (C1-)
unnamed: CO11.2, IC3.5 (C1+)
unnamed: IC5.3 (-IN), ORP.CON_GND, RO3.2
unnamed: IC5.1 (RG), RG1_ORP.1
unnamed: RG1_ORP.2, RG2_ORP.2
unnamed: IC5.16 (RG), RG2_ORP.1
unnamed: IC9.1 (ADDR), RO7.1, RO9.2
unnamed: IC9.2 (ALERT/RDY), RO8.1
unnamed: AIN2_ORP.TP, IC9.6 (AIN2), RO10.2
unnamed: AIN3_ORP.TP, IC9.7 (AIN3), RO11.2
SCL: IC1.2 (SCL2); also elsewhere on the board
SCL_ISO_ORP: IC1.19 (SCL1), IC9.10 (SCL), RO2.1
SDA: IC1.3 (SDA2); also elsewhere on the board
SDA_ISO_ORP: IC1.18 (SDA1), IC9.9 (SDA), RO1.1
SIG_ORP: CO15.2, IC9.5 (AIN1), RO12.2, TP_SIG_ORP.TP
SUPP_ADS_ORP: CO14.2, IC9.8 (VDD), RO7.2, RO8.2, SJ1.2
VCC_ORP_ENA: IC1.8 (PDIS), RO13.2; also elsewhere on the board
VREF_ORP: IC9.4 (AIN0), IC11.3 (+IN), RO6.2, RO14.1, TP_VREF_ORP.TP
VSEL: IC1.13 (VSEL), RO_BOT.2, RO_TOP.1

Notes on the sheet:
ORP
A. Koller

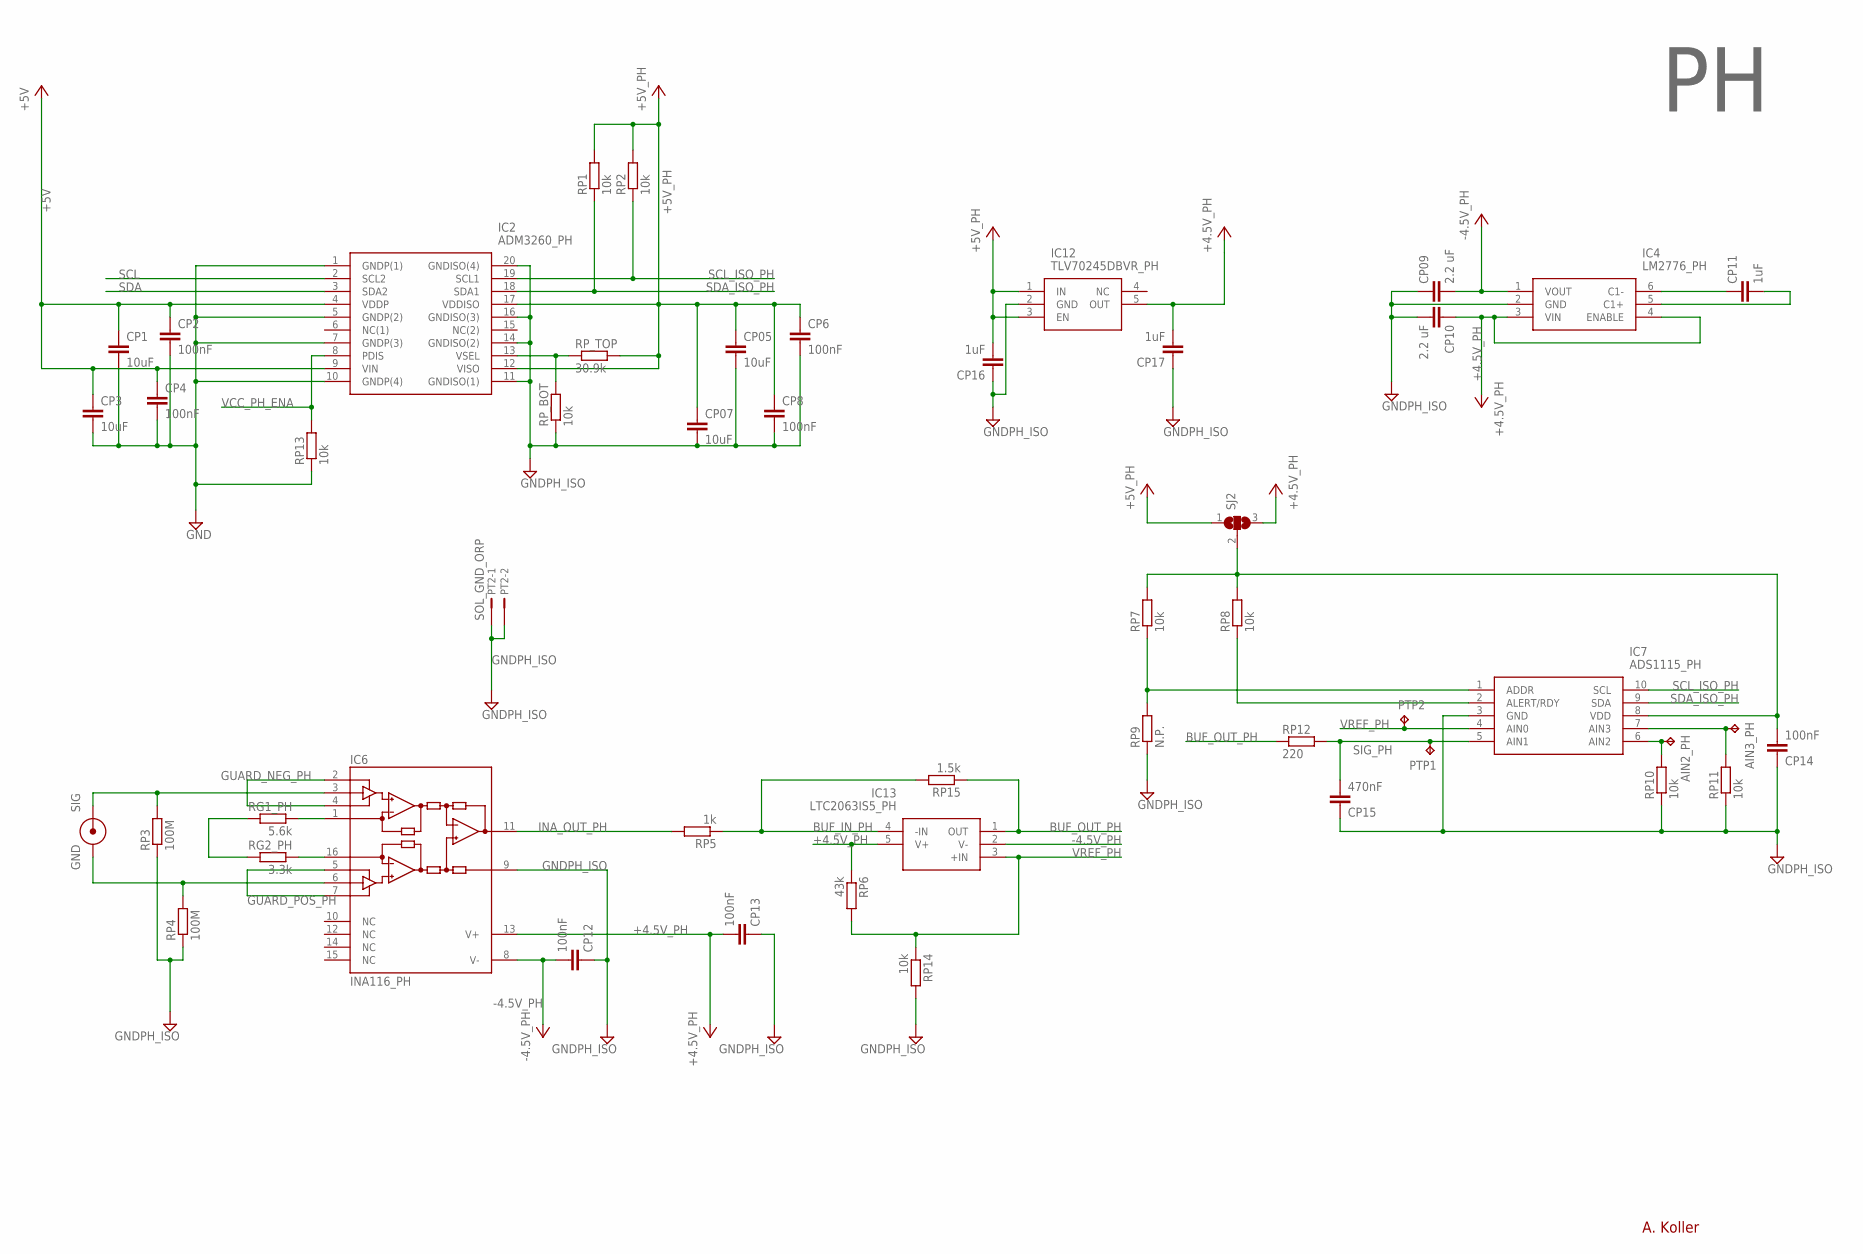
[picture p44: schematic pHORPBoard_V10.sch, sheet 3]

Parts:
AIN2_PH, AIN3_PH: TPB1,27; B1,27
CP1, CP3, CP05, CP07: 10uF; C0603
CP2, CP4, CP6, CP8, CP12, CP13, CP14: 100nF; C0603
CP09, CP10: 2.2 uF; C0603
CP11, CP16, CP17: 1uF; C0603
CP15: 470nF; C0603
IC2: ADM3260_PH; SOP65P780X200-20N
IC4: LM2776_PH; SOT95P280X145-6N
IC6: INA116_PH; SO16-1
IC7: ADS1115_PH; SOP50P490X110-10N
IC12: TLV70245DBVR_PH; SOT95P280X145-5N
IC13: LTC2063IS5_PH; SOT95P280X100-5N
PH: CON_HANNA
PT2: SOL_GND_ORP; B2B-ZR
PTP1, PTP2: TPB1,27; B1,27
RG1_PH: 5.6k; R0603
RG2_PH: 3.3k; R0603
RP1, RP2, RP7, RP8, RP10, RP11, RP13, RP14: 10k; R0603
RP3, RP4: 100M; R0603
RP5: 1k; R0603
RP6: 43k; R0603
RP9: N.P.; R0603
RP12: 220; R0603
RP15: 1.5k; R0603
RP_BOT: 10k; R0603
RP_TOP: 30.9k; R0603
SJ2: SJ2W; SJ_2

Connections:
+4.5V_PH: CP10.1, CP13.2, CP17.2, IC4.3 (VIN), IC4.4 (ENABLE), IC6.13 (V+), IC12.5 (OUT), IC13.5 (V+), RP6.1, SJ2.3
+5V: CP1.1, CP2.1, CP3.1, CP4.1, IC2.4 (VDDP), IC2.9 (VIN); also elsewhere on the board
+5V_PH: CP05.1, CP6.1, CP07.1, CP8.1, CP16.2, IC2.12 (VISO), IC2.17 (VDDISO), IC12.1 (IN), IC12.3 (EN), RP1.2, RP2.2, RP_TOP.2, SJ2.1
-4.5V_PH: CP09.2, CP12.2, IC4.1 (VOUT), IC6.8 (V-), IC13.2 (V-)
BUF_IN_PH: IC13.4 (-IN), RP5.1, RP15.2
BUF_OUT_PH: IC13.1 (OUT), RP12.1, RP15.1
GND: CP1.2, CP2.2, CP3.2, CP4.2, IC2.1 (GNDP(1)), IC2.5 (GNDP(2)), IC2.7 (GNDP(3)), IC2.10 (GNDP(4)), RP13.1; also elsewhere on the board
GNDPH_ISO: CP05.2, CP6.2, CP07.2, CP8.2, CP09.1, CP10.2, CP12.1, CP13.1, CP14.1, CP15.1, CP16.1, CP17.1, IC2.11 (GNDISO(1)), IC2.14 (GNDISO(2)), IC2.16 (GNDISO(3)), IC2.20 (GNDISO(4)), IC4.2 (GND), IC6.9 (REF), IC7.3 (GND), IC12.2 (GND), PT2.1, PT2.2, RP3.1, RP4.1, RP9.1, RP10.1, RP11.1, RP14.2, RP_BOT.1
GUARD_NEG_PH: IC6.2 (GUARD-), IC6.4 (GUARD-)
GUARD_POS_PH: IC6.5 (GUARD+), IC6.7 (GUARD+)
INA_OUT_PH: IC6.11 (OUT), RP5.2
unnamed: CP11.1, IC4.6 (C1-)
unnamed: CP11.2, IC4.5 (C1+)
unnamed: IC6.1 (RG), RG1_PH.1
unnamed: RG1_PH.2, RG2_PH.2
unnamed: IC6.16 (RG), RG2_PH.1
unnamed: IC6.6 (+IN), PH.CON_GND, RP4.2
unnamed: IC6.3 (-IN), PH.CON_SIG, RP3.2
unnamed: IC7.1 (ADDR), RP7.1, RP9.2
unnamed: IC7.2 (ALERT/RDY), RP8.1
unnamed: AIN2_PH.TP, IC7.6 (AIN2), RP10.2
unnamed: AIN3_PH.TP, IC7.7 (AIN3), RP11.2
SCL: IC2.2 (SCL2); also elsewhere on the board
SCL_ISO_PH: IC2.19 (SCL1), IC7.10 (SCL), RP2.1
SDA: IC2.3 (SDA2); also elsewhere on the board
SDA_ISO_PH: IC2.18 (SDA1), IC7.9 (SDA), RP1.1
SIG_PH: CP15.2, IC7.5 (AIN1), PTP1.TP, RP12.2
SUPP_ADS_PH: CP14.2, IC7.8 (VDD), RP7.2, RP8.2, SJ2.2
VCC_PH_ENA: IC2.8 (PDIS), RP13.2; also elsewhere on the board
VREF_PH: IC7.4 (AIN0), IC13.3 (+IN), PTP2.TP, RP6.2, RP14.1
VSEL1: IC2.13 (VSEL), RP_BOT.2, RP_TOP.1

Notes on the sheet:
A. Koller

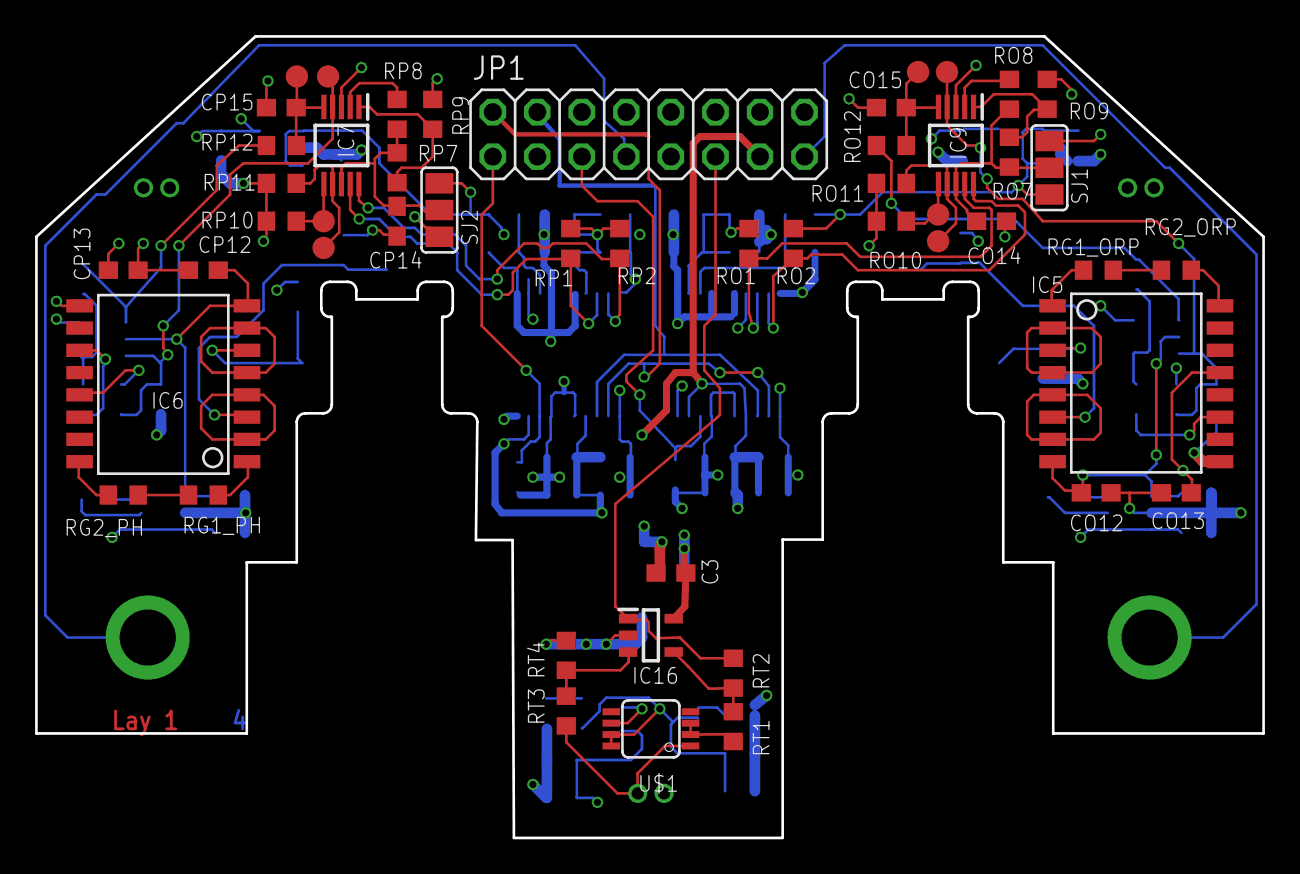
[picture p45: board pHORPBoard_V10.brd from above]

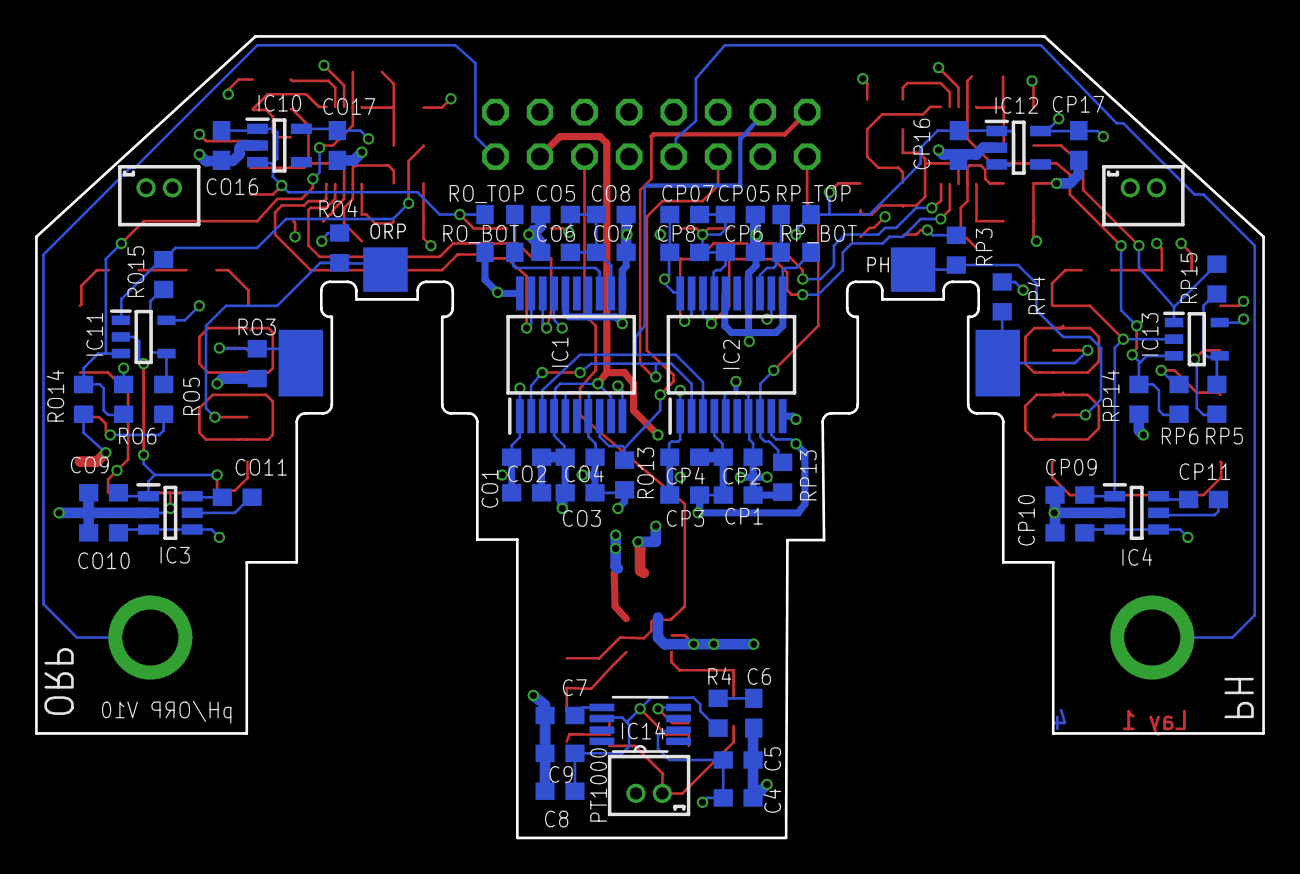
[picture p46: board pHORPBoard_V10.brd from below]

Board: 4 copper layers, 70.0 x 45.7 mm, 115 parts (65 on the bottom side), 67 nets.
