eawag-squid/SQUID/hardware/ECBoard_V3/ECBoard_v3.brd

## EAGLE design hardware/ECBoard_V3/ECBoard_v3.brd (2019-11-29)

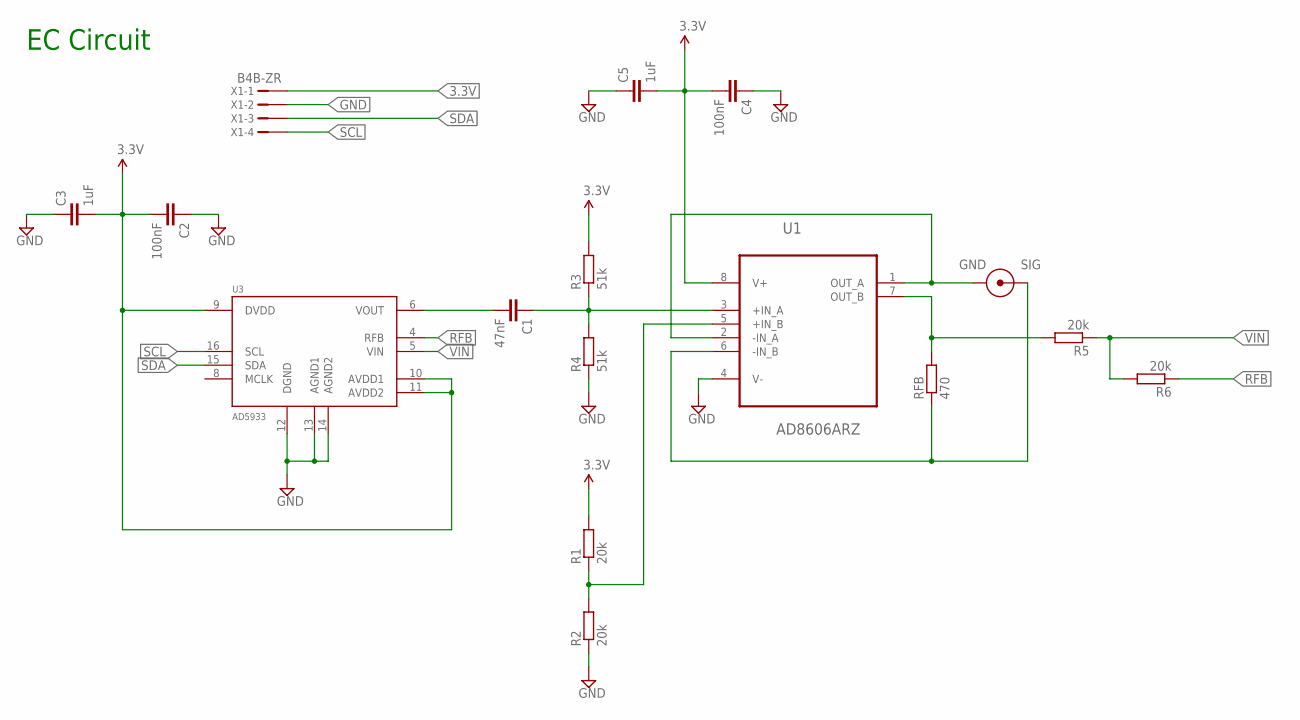
[picture p47: schematic ECBoard_v3.sch, sheet 1]

Parts:
C1: 47nF; C0805
C2, C4: 100nF; C0805
C3, C5: 1uF; C0805
R1, R2, R5, R6: 20k; R0805
R3, R4: 51k; R0805
RFB: 470; R0805
U1: AD8606ARZ; SOIC127P600X175-8N
U3: AD5933; SSOP16
U$1: CON_HANNA
X1: B4B-ZR

Connections:
3.3V: C2.2, C3.2, C4.2, C5.2, R1.2, R3.2, U1.8 (V+), U3.9 (DVDD), U3.10 (AVDD1), U3.11 (AVDD2), X1.1; also elsewhere on the board
GND: C2.1, C3.1, C4.1, C5.1, R2.1, R4.1, U1.4 (V-), U3.12 (DGND), U3.13 (AGND1), U3.14 (AGND2), X1.2; also elsewhere on the board
unnamed: C1.1, R3.1, R4.2, U1.3 (+IN_A)
unnamed: U1.1 (OUT_A), U1.2 (-IN_A), U$1.CON_GND
unnamed: C1.2, U3.6 (VOUT)
unnamed: RFB.1, U1.6 (-IN_B), U$1.CON_SIG
unnamed: R1.1, R2.2, U1.5 (+IN_B)
unnamed: R5.2, RFB.2, U1.7 (OUT_B)
RFB: R6.1, U3.4 (RFB)
SCL: U3.16 (SCL), X1.4
SDA: U3.15 (SDA), X1.3
VIN: R5.1, R6.2, U3.5 (VIN)

Notes on the sheet:
EC Circuit
