eawag-squid/SQUID/hardware/ECBoard_V3/ECBoard_v3.brd

## EAGLE design hardware/ECBoard_V3/ECBoard_v3.brd (continued)

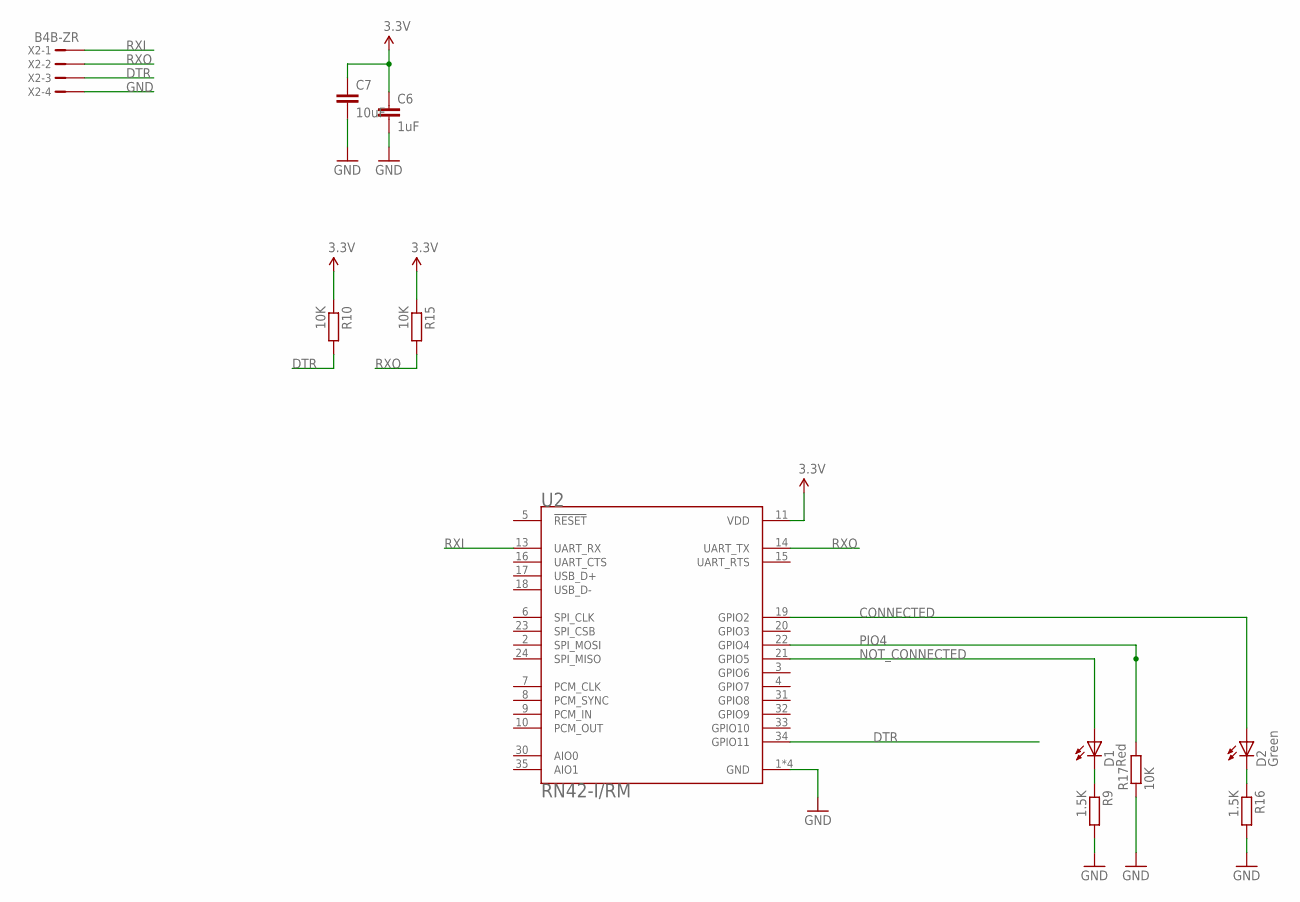
[picture p48: schematic ECBoard_v3.sch, sheet 2]

Parts:
C6: 1uF; C0805
C7: 10uF; C0805
D1: Red; LED-0603
D2: Green; LED-0603
R9, R16: 1.5K; R0805
R10, R15, R17: 10K; R0805
U2: RN42-I/RM; XCVR_RN42-I/RM
X2: B4B-ZR

Connections:
3.3V: C6.1, C7.1, R10.1, R15.1, U2.11 (VDD); also elsewhere on the board
CONNECTED: D2.A, U2.19 (GPIO2)
D1: D1.C, R9.1
D2: D2.C, R16.1
DTR: R10.2, U2.34 (GPIO11), X2.3
GND: C6.2, C7.2, R9.2, R16.2, R17.1, U2.1 (GND), U2.12 (GND), U2.28 (GND), U2.29 (GND), X2.4; also elsewhere on the board
NOT_CONNECTED: D1.A, U2.21 (GPIO5)
PIO4: R17.2, U2.22 (GPIO4)
RXI: U2.13 (UART_RX), X2.1
RXO: R15.2, U2.14 (UART_TX), X2.2

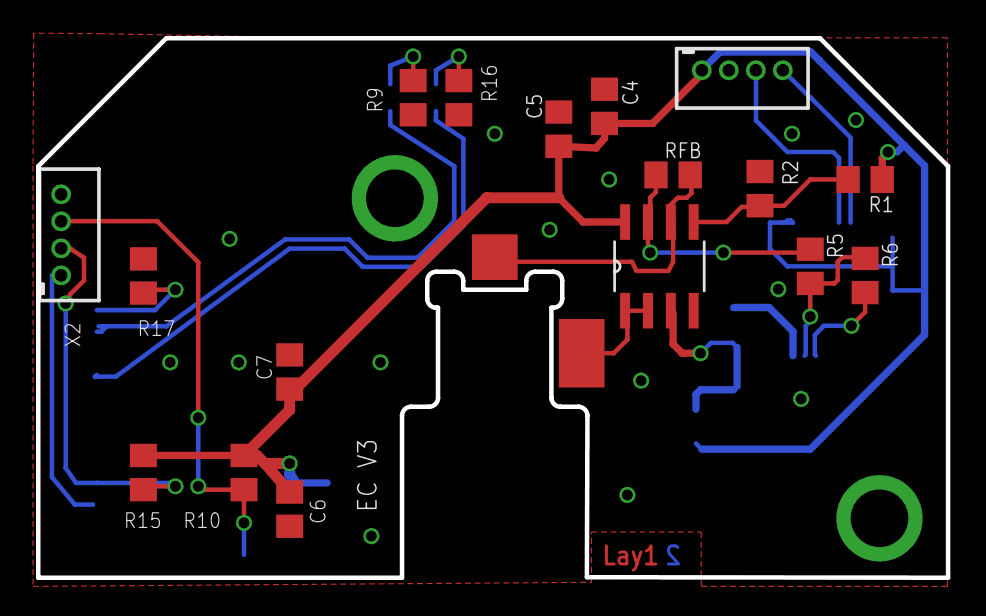
[picture p49: board ECBoard_v3.brd from above]

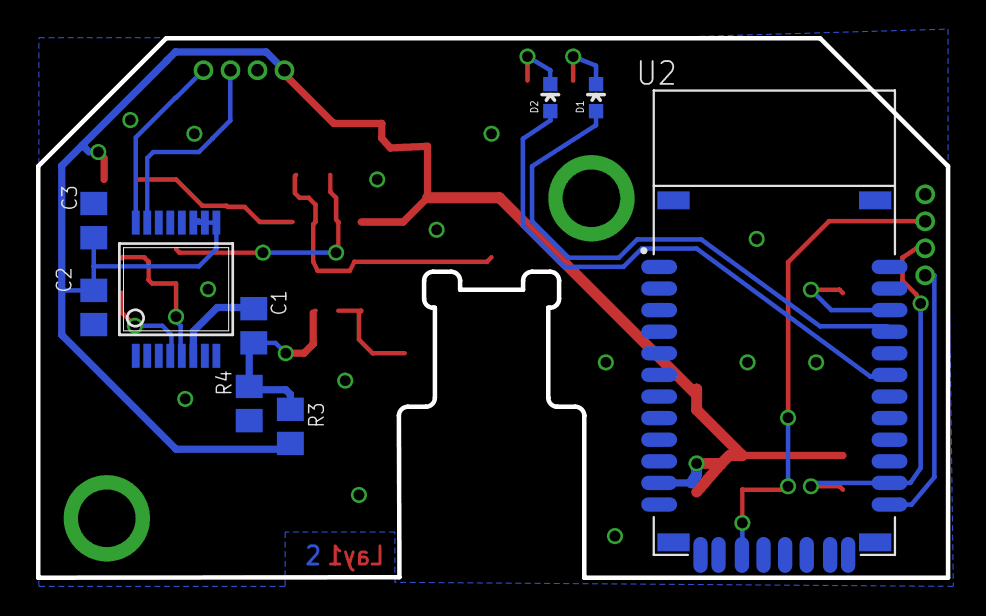
[picture p50: board ECBoard_v3.brd from below]

Board: 2 copper layers, 50.5 x 30.0 mm, 27 parts (9 on the bottom side), 20 nets.
