eawag-squid/SQUID/hardware/APMiniMax_V2/APMiniMax_V2.brd

## EAGLE design hardware/APMiniMax_V2/APMiniMax_V2.brd (2019-11-29)

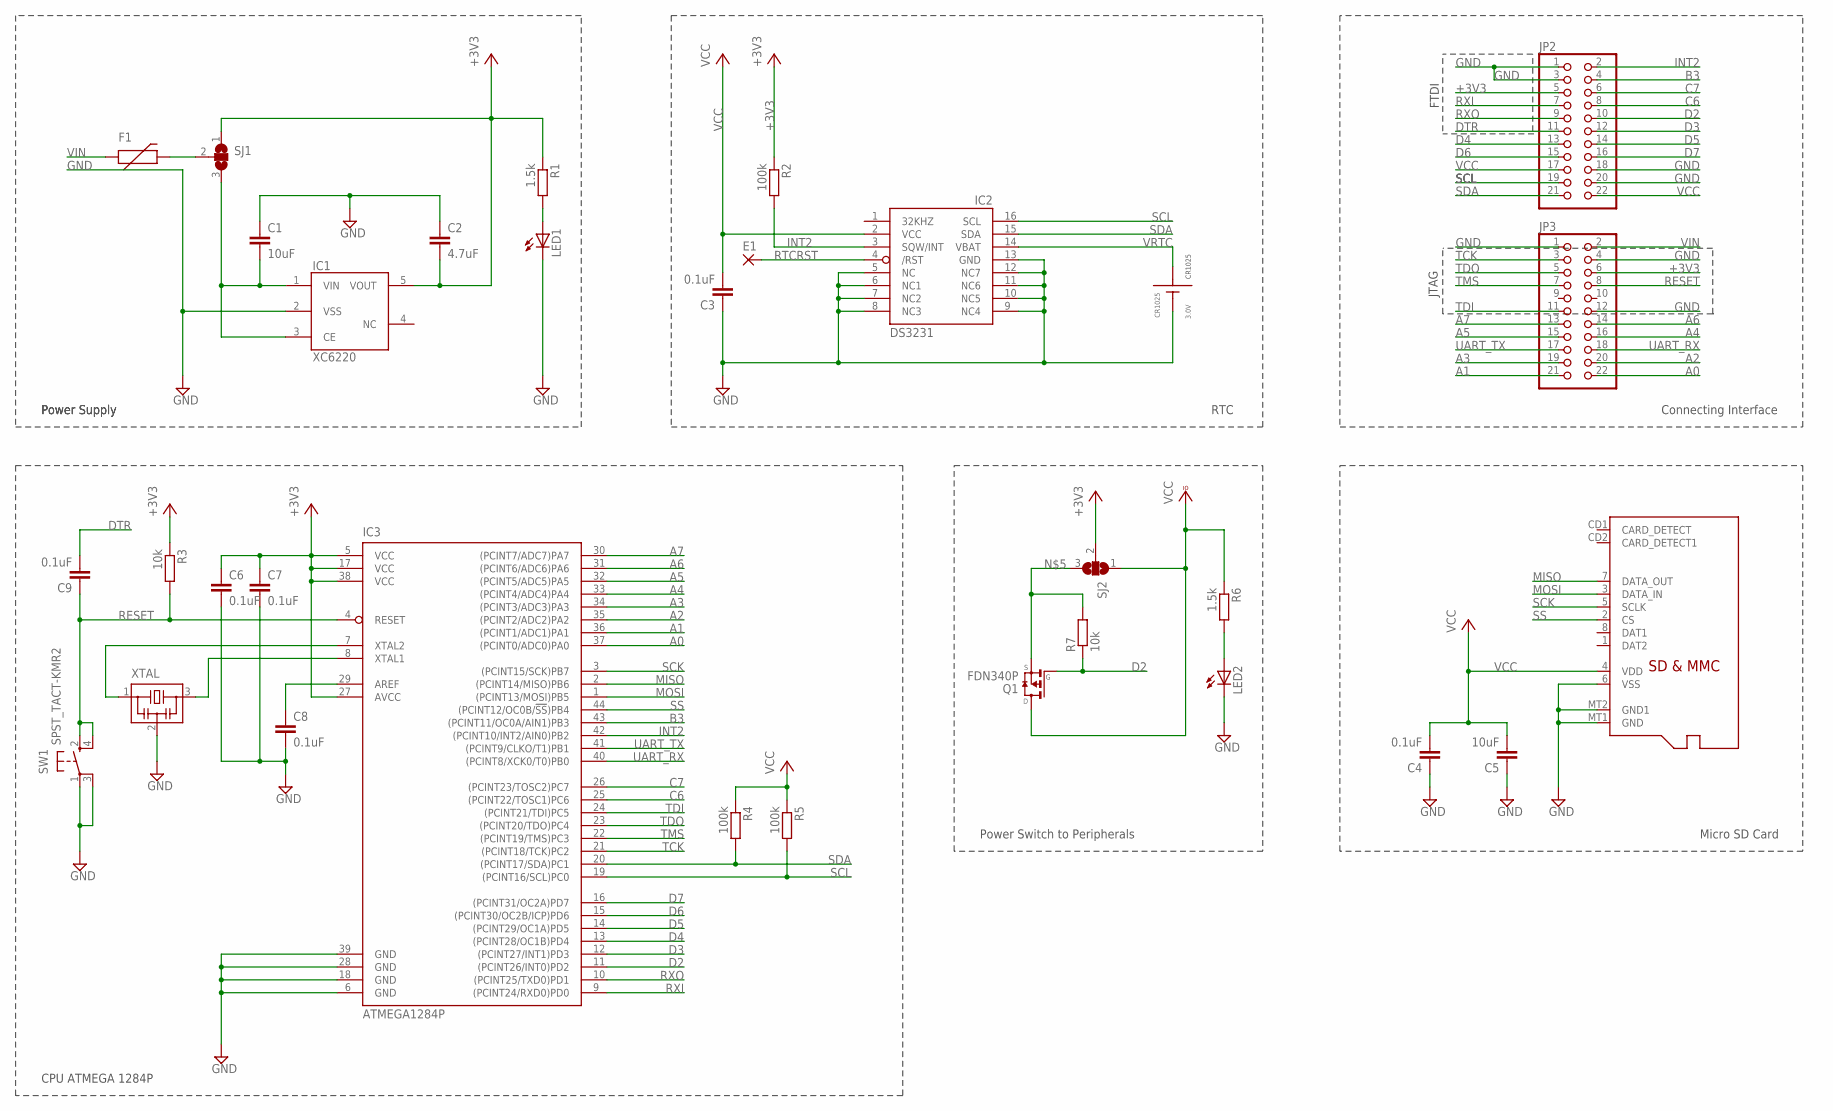
[picture p51: schematic APMiniMax_V2.sch]

Parts:
C1, C5: 10uF; C1206
C2: 4.7uF; C1206
C3, C4, C6, C7, C8, C9: 0.1uF; C0805
CR1025: 3.0V; CR1025SMD
E1: 0,75/0,5
F1: FUSE0805; R0805
IC1: XC6220SOT-25; SOT25
IC2: DS3231/SO; SO16W
IC3: ATMEGA1284P; TQFP44
JP2, JP3: PINHD-2X11; 2X11
LED1, LED2: LEDCHIP-LED0805; CHIP-LED0805
MMC: MICROSD
Q1: FDN340P; SSOT-3
R1, R6: 1.5k; R0805
R2, R4, R5: 100k; R0805
R3, R7: 10k; R0805
SJ1, SJ2: SJ2W; SJ_2
SW1: SPST_TACT-KMR2; KMR2
XTAL: CSTCE8M00G52-R0; CSTCE

Connections:
+3V3: C2.2, C6.1, C7.1, IC1.5 (VOUT), IC3.5 (VCC), IC3.17 (VCC), IC3.27 (AVCC), IC3.38 (VCC), JP2.5, JP3.6, R1.1, R2.1, R3.1, SJ1.1, SJ2.2
A0: IC3.37 ((PCINT0/ADC0)PA0), JP3.22
A1: IC3.36 ((PCINT1/ADC1)PA1), JP3.21
A2: IC3.35 ((PCINT2/ADC2)PA2), JP3.20
A3: IC3.34 ((PCINT3/ADC3)PA3), JP3.19
A4: IC3.33 ((PCINT4/ADC4)PA4), JP3.16
A5: IC3.32 ((PCINT5/ADC5)PA5), JP3.15
A6: IC3.31 ((PCINT6/ADC6)PA6), JP3.14
A7: IC3.30 ((PCINT7/ADC7)PA7), JP3.13
AREF: C8.1, IC3.29 (AREF)
B3: IC3.43 ((PCINT11/OC0A/AIN1)PB3), JP2.4
C6: IC3.25 ((PCINT22/TOSC1)PC6), JP2.8
C7: IC3.26 ((PCINT23/TOSC2)PC7), JP2.6
D2: IC3.11 ((PCINT26/INT0)PD2), JP2.10, Q1.1 (G), R7.1
D3: IC3.12 ((PCINT27/INT1)PD3), JP2.12
D4: IC3.13 ((PCINT28/OC1B)PD4), JP2.13
D5: IC3.14 ((PCINT29/OC1A)PD5), JP2.14
D6: IC3.15 ((PCINT30/OC2B/ICP)PD6), JP2.15
D7: IC3.16 ((PCINT31/OC2A)PD7), JP2.16
DTR: C9.2, JP2.11
GND: C1.1, C2.1, C3.1, C4.1, C5.1, C6.2, C7.2, C8.2, CR1025.GND, IC1.2 (VSS), IC2.5 (NC), IC2.6 (NC1), IC2.7 (NC2), IC2.8 (NC3), IC2.9 (NC4), IC2.10 (NC5), IC2.11 (NC6), IC2.12 (NC7), IC2.13 (GND), IC3.6 (GND), IC3.18 (GND), IC3.28 (GND), IC3.39 (GND), JP2.1, JP2.3, JP2.18, JP2.20, JP3.1, JP3.4, JP3.12, LED1.C, LED2.C, MMC.6 (VSS), MMC.MT1 (GND), MMC.MT2 (GND1), SW1.1, SW1.3 (P1), XTAL.2
INT2: IC2.3 (SQW/INT), IC3.42 ((PCINT10/INT2/AIN0)PB2), JP2.2, R2.2
MISO: IC3.2 ((PCINT14/MISO)PB6), MMC.7 (DATA_OUT)
MOSI: IC3.1 ((PCINT13/MOSI)PB5), MMC.3 (DATA_IN)
unnamed: LED1.A, R1.2
unnamed: F1.2, SJ1.2
unnamed: C1.2, IC1.1 (VIN), IC1.3 (CE), SJ1.3
unnamed: Q1.2 (S), R7.2, SJ2.3
unnamed: IC3.7 (XTAL2), XTAL.1
unnamed: IC3.8 (XTAL1), XTAL.3
unnamed: LED2.A, R6.2
RESET: C9.1, IC3.4 (RESET), JP3.8, R3.2, SW1.2 (S), SW1.4 (S1)
RTCRST: E1.1, IC2.4 (/RST)
RXI: IC3.9 ((PCINT24/RXD0)PD0), JP2.7
RXO: IC3.10 ((PCINT25/TXD0)PD1), JP2.9
SCK: IC3.3 ((PCINT15/SCK)PB7), MMC.5 (SCLK)
SCL: IC2.16 (SCL), IC3.19 ((PCINT16/SCL)PC0), JP2.19, R5.2
SDA: IC2.15 (SDA), IC3.20 ((PCINT17/SDA)PC1), JP2.21, R4.2
SS: IC3.44 ((PCINT12/OC0B/!SS!)PB4), MMC.2 (CS)
TCK: IC3.21 ((PCINT18/TCK)PC2), JP3.3
TDI: IC3.24 ((PCINT21/TDI)PC5), JP3.11
TDO: IC3.23 ((PCINT20/TDO)PC4), JP3.5
TMS: IC3.22 ((PCINT19/TMS)PC3), JP3.7
UART_RX: IC3.40 ((PCINT8/XCK0/T0)PB0), JP3.18
UART_TX: IC3.41 ((PCINT9/CLKO/T1)PB1), JP3.17
VCC: C3.2, C4.2, C5.2, IC2.2 (VCC), JP2.17, JP2.22, MMC.4 (VDD), Q1.3 (D), R4.1, R5.1, R6.1, SJ2.1
VIN: F1.1, JP3.2
VRTC: CR1025.V+@1 (V+), CR1025.V+@2 (V+), IC2.14 (VBAT)

Notes on the sheet:
JTAG
FTDI
Power Supply
CPU ATMEGA 1284P
RTC
Connecting Interface
Micro SD Card
Power Switch to Peripherals

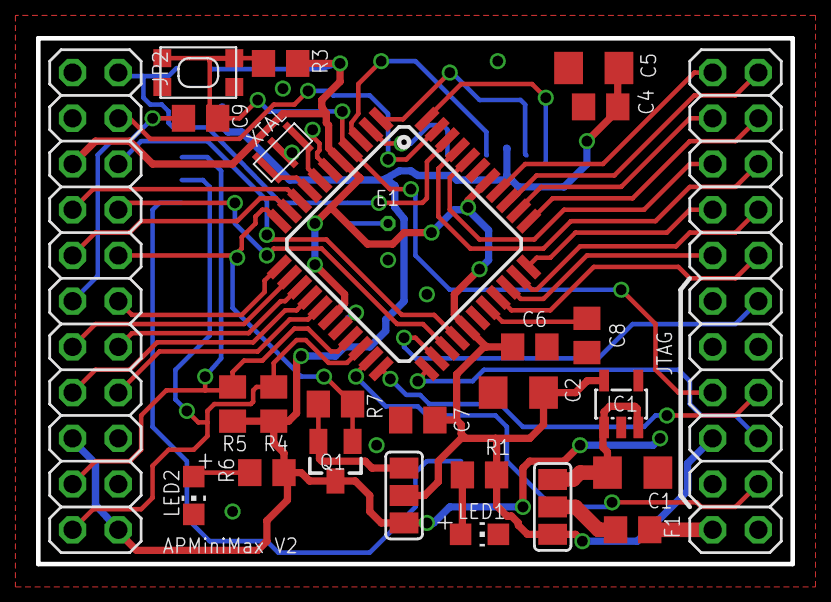
[picture p52: board APMiniMax_V2.brd from above]

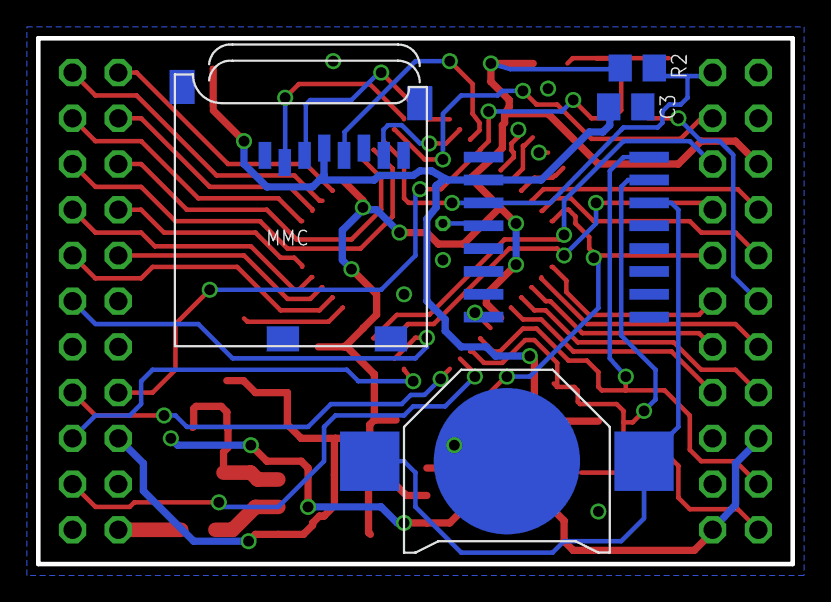
[picture p53: board APMiniMax_V2.brd from below]

Board: 2 copper layers, 41.9 x 29.2 mm, 32 parts (5 on the bottom side), 48 nets.
