eawag-squid/SQUID/(commit log)

2019-04-17 Current format for firmware version V4 and newer
    [RTC.CFG]
2019-04-17 new configuration file for firmware version V5
    [SENS_V5.CFG]
2019-04-17 configuration files moved to separate folder
    [SENS_V3.CFG]
2019-04-17 version V5.1
    Compatibility:
    - this firmware can only be used for hardware built later than December 2018 with the new pHORPBoard V7 and newer
    New features and modifications
    - new calibration method: 3 point calibration for pH, single point calibration for EC
    - fixed bug: store EC values with more digits on MIcroSD card, time and data for files on MicroSD card
    - support for Bluetooth modem
    - user menu for setting RTC and calibration
    - ZModem protocol support for downloading data files and uploding configuration
2019-05-08 user menu for calibration optimized
2019-09-24 added new parameters
    parameters for measurement cycle and energy consumtion (buzzer/LED control) added
    [SENS_V5.CFG]
2019-11-29 - current version with bluetooth and magnetic switch
    [APMiniMax_V2.brd, APMiniMax_V2.sch, BOM_APMiniMax_V2.csv, BOM_CarrierBoard_V7.csv, BOM_ECBoard_v3.csv, CarrierBoard_V7.brd, CarrierBoard_V7.sch, ECBoard_v3.brd]
2020-01-20 - update V5.3
    [Configuration.h, RTC.CFG, SENS_V5.CFG]
2021-02-11 - fixed config issue with alpha value - fixed hanging EC reading - writing serial number does not require separate firmware
    [Configuration.h, RTC.CFG, SENS_V5.CFG, SN.CFG]
2021-02-11 - new config file for firmware V5.5
    [SN.CFG]
